Glenn-IT/WBACFSPWI-Web-Based-Automatic-Controller-for-Solar-Powered-Water-Irrigation/Progress.md

# Project Progress

progress: 90
status: Ongoing
note: Completed standalone Arduino hardware sketches, HW-080 surface moisture integration, star wiring breadboard diagrams, and automated controller firmware.

Backend: 85
Frontend: 85
Database: 85
Arduino Hardware & Integration: 90
Total: 90
