Glenn-IT/WBACFSPWI-Web-Based-Automatic-Controller-for-Solar-Powered-Water-Irrigation/arduino/figure4_prototype_guide.html

Hardware Prototype Guide

# Figure 4 Standalone ESP32 Prototype Wiring

Complete electrical schematic, pinout mapping, and star-ground wiring instructions for the solar-powered automatic irrigation prototype shown in Figure 4.

### Live Digital Prototype Available

You can test this exact hardware circuit interactively in your browser with animated water pumps, solar irradiance controls, and smartphone telemetry.

Open Interactive Simulator → Open Mobile Phone View ← Master Hardware Hub

🔌 Visual Star Wiring Diagram (Figure 4 Architecture)

This vector diagram illustrates the physical jumper connections between the Solar Panel, Solar Charge Controller, 12V Battery, Solderless Breadboard, ESP32, Soil Probe, Relay Module, and 12V Water Pump.

📋 Full Hardware Connection Matrix

Tag | Source Component | Source Pin / Terminal | Destination Component | Destination Pin | Wire Color | Purpose & Interface
SOL-01 | Solar Panel (30W) | PV Positive (+) | Solar Charge Controller | PV (+) Terminal | Red | Solar harvesting input (18V–21V Voc)
SOL-02 | Solar Panel (30W) | PV Negative (-) | Solar Charge Controller | PV (-) Terminal | Black | Solar panel ground return
BAT-01 | 12V Battery | Positive (+) Terminal | Solar Charge Controller | BATT (+) Terminal | Red | Battery charging and storage connection
BAT-02 | 12V Battery | Negative (-) Terminal | Solar Charge Controller | BATT (-) Terminal | Black | Battery ground reference
PWR-01 | Solar Controller / Battery | Load / Batt (+) | Breadboard | Red Power Rail (+5V / +12V) | Red | System power distribution bus
GND-01 | Solar Controller / Battery | Load / Batt (-) | Breadboard | Blue Ground Rail (GND) | Black | Star common ground bus
SIG-01 | ESP32 DevKit | GPIO 34 (ADC1) | Soil Moisture Module | AO (Analog Out) | Green | Analog soil moisture voltage sensing (12-bit)
SIG-02 | ESP32 DevKit | GPIO 25 | Soil Moisture Module | VCC | Yellow | Power gating pin (prevents probe corrosion)
ACT-01 | ESP32 DevKit | GPIO 26 | Relay Module | IN (Control Pin) | Blue | Active-LOW digital relay trigger
ACT-02 | Relay Module | Normally Open (NO) | 12V DC Water Pump | Positive (+) Lead | Red | Switched high-side 12V pump power
ACT-03 | 12V DC Water Pump | Negative (-) Lead | Breadboard | Blue Ground Rail (GND) | Black | Pump motor return path to common ground

📦 Prototype Bill of Materials (BOM)

- 1x 12V/30W Polycrystalline Solar Panel with standard mounting bracket
- 1x 10A/20A 12V PWM Solar Charge Controller with integrated LCD status screen
- 1x 12V Motorcycle Lead-Acid or 3S 18650 Li-ion Battery Pack (11.1V–12.6V)
- 1x 830-Point Solderless Breadboard with dual power distribution buses
- 1x ESP32 NodeMCU-32S / ESP-WROOM-32 30-pin/38-pin Development Board
- 1x Soil Moisture Sensor Module with LM393 comparator & dual-prong probe
- 1x 5V/3.3V 1-Channel Optocoupler Relay Module (10A 250VAC / 30VDC rating)
- 1x 12V DC Submersible/Diaphragm Miniature Water Pump with silicone tubing
- Assorted Jumper Wires (Male-to-Male and Male-to-Female)
