Glenn-IT/WBACFSPWI-Web-Based-Automatic-Controller-for-Solar-Powered-Water-Irrigation/arduino/wbacfspwi_arduino_controller/wiring_guide.html

Master Full Controller Wiring Schematic

# WBACFSPWI Master Star Breadboard Assembly Guide

Complete High-Visibility Wiring Schematic: 30W Solar Panel + Solar Charge Controller/BMS + 12V Motorcycle / 3S Battery + Buck (5V) Main Power | Dark Breadboard | Connected Star Jumpers | HW-080 & Capacitive Dual-Sensor Setup

🏠 Master Hub Test 01: Root Soil Test 02: HW-080 Surface Test 03: Relay & Pump Test 04: Battery Monitor Test 05: Solar Monitor Test 06: Solar Charger Test 07: Dual Sensor Test 08: 12V Presentation 📡 Test 09: ESP8266 WiFi 📱 Test 10: GSM SMS Alert 🚀 Full Controller ⚡ Interactive Prototype

🎛️

Interactive Subsystem & Module Filter

Check options below to show/hide specific circuits on the schematic diagram and connection matrix table.

🌱 Root Soil + HW-080 Only 🔬 All Sensors Only ⚡ Power & Actuators ✨ Show All (Reset)

🌱 Root Soil Moisture (Capacitive V1.2) 🌊 HW-080 Surface Moisture Probe ☀️ 30W Solar Panel & 22V Divider 🔌 3S Solar Charge Controller / BMS 🔋 3S Battery Pack & 12V Divider ⚡ LM2596 Buck & 5V Power Rails 🚰 5V Relay & Submersible Water Pump 📡 NodeMCU ESP8266MOD WiFi Bridge 📱 SIM800L GSM SMS Alert System

Showing 9 of 9 Subsystem Modules

⚡

Master Circuit Schematic (Dark Breadboard with 100% Fully Connected Terminals & Solar Charger)

Star 5V Logic Power (Red)

Star Common Ground 0V (Blue)

Solar Charger to Battery (12.6V CC/CV)

12V Battery Power / A2 Divider (Purple)

22V Solar Power / A3 Divider (Gold)

Relay Trigger D7 / DO D2 (Amber)

Capacitive Power Gate D8 (Pink)

Root Soil Signal A0 (Green)

HW-080 Surface Signal A1 (Cyan)

NodeMCU ESP8266 WiFi Bridge (D9 RX / D10 TX)

📊

Complete Master Breadboard Pin & Component Connection Matrix

Wire ID | Origin Node (From) | Breadboard Tie-Point | Destination Node (To) | Wire Color | Signal Type / Voltage | Operational Function & Safety Rule
CHG-01 | 30W Solar (+) Lead [0-22V] | Direct Wire | Solar Charger SOLAR IN+ | Gold / Red | 0V – 21.6V DC | Raw solar output into 3S MPPT/PWM solar charge controller module.
CHG-02 | 30W Solar (-) Lead | Top Blue Rail (-) | Solar Charger SOLAR IN- | Blue / Black | 0.00V (Common) | Solar ground return tied into common Star Ground bus.
CHG-03 | Solar Charger BAT+ Out | Direct Heavy Wire | 12V Motorcycle / 3S Battery (+) [11.1V–14.4V] | Purple / Red | 12.60V–14.40V Charge | Regulated charging current feeds 12V Motorcycle / 3S battery pack (overcharge protected).
CHG-04 | Solar Charger BAT- Out | Top Blue Rail (-) | 12V Motorcycle / 3S Battery (-) Terminal | Blue / Black | 0.00V (Common) | Battery charge ground return to central Star Ground reference.
PWR-01 | 12V Motorcycle / 3S Battery (+) [11.1V–14.4V] | Direct Wire | LM2596 Buck IN+ | Red | 11.1V – 14.4V DC | Raw high-capacity battery supply to Buck step-down converter (10A inline fuse recommended).
PWR-02 | LM2596 Buck OUT+ | Top Red Rail (+) | Arduino 5V Pin | Red | 5.00V DC Regulated | Primary Logic Power: Powers Arduino ATmega328P MCU.
PWR-03 | Top Red Rail (+) | Direct Jumper | 5V Relay Module VCC | Red | 5.00V DC | Powers optocoupler coil driver circuitry.
PWR-04 | Top Red Rail (+) | Direct Jumper | HW-080 Driver VCC | Red | 5.00V DC | Powers LM393 surface moisture comparator driver board.
PWR-05 | Top Red Rail (+) | Direct Jumper | NodeMCU Vin Pin | Red | 5.00V DC Regulated | Supplies regulated 5V into NodeMCU onboard AMS1117 3.3V LDO regulator.
GND-01 | LM2596 Buck OUT- | Top Blue Rail (-) | Arduino GND Pin | Blue / Slate | 0.00V (Star GND) | Star Ground Reference: Central zero-volt reference point.
GND-02 | 12V Motorcycle / 3S Battery (-) Terminal | Top Blue Rail (-) | Buck IN- Terminal | Blue / Black | 0.00V (Common) | Ties battery negative return directly into central star ground.
GND-03 | 30W Solar (-) Terminal | Top Blue Rail (-) | Star Common GND | Blue / Black | 0.00V (Common) | Ties solar panel return into common ground bus.
GND-04 | Relay GND & Sensors GND | Top Blue Rail (-) | Star Common GND | Blue / Slate | 0.00V | Ground returns for relay coil, capacitive sensor, and HW-080.
GND-05 | NodeMCU GND & 2kΩ Div | Top Blue Rail (-) | Star Common GND | Blue / Slate | 0.00V (Common) | Common 0V reference return for ESP8266 logic and RX voltage divider.
ACT-01 | 12V Motorcycle / 3S Battery (+) [11.1V–14.4V] | Direct Heavy Wire | Relay COM Terminal | Purple / Red | 11.1V–14.4V High Current | Feeds raw un-stepped battery power to relay switch contacts (16/18 AWG recommended).
ACT-02 | Relay NO Terminal | Row 35 (Diode Cathode) | DC Pump (+) Lead | Blue | Switched 12V DC | Powers water pump motor when relay is engaged.
ACT-03 | DC Pump (-) Lead | Row 40 (Diode Anode) | Star GND Rail (-) | Blue / Black | Motor Return GND | Motor return current flows into Star GND, bypassing Arduino MCU.
ACT-04 | Row 35 (Cathode) | 1N4007 Diode Body | Row 40 (Anode) | Diode Component | Flyback Clamp | Inductive Spike Suppression: Clamps reverse-EMF kickback.
SIG-01 | Arduino Pin D7 | Direct Jumper | Relay IN Pin | Amber | 5V Digital Out | Active LOW trigger with 3-minute continuous runtime safety cap.
SIG-02 | Arduino Pin D8 | Direct Jumper | Capacitive Sensor VCC | Pink / Red | 5V Digital Gate | Powers capacitive sensor only during sampling (anti-corrosion).
SIG-03 | Capacitive Sensor AOUT | Direct Jumper | Arduino Pin A0 | Green | 0V – 3.0V Analog | Root zone soil moisture reading (Air ~417, Water ~153).
SIG-04 | HW-080 Sensor AO | Direct Jumper | Arduino Pin A1 | Cyan | 0V – 5.0V Analog | Surface ponding depth controller (Dry=1020, Mid=663, Full=568). Maintains 50.0% target layer (Target 50.0%, Refill min 45.0%).
SIG-05 | Row 10 (R1/R2 Junction) | 100kΩ / 33kΩ Divider | Arduino Pin A2 | Purple | 0V – 3.57V Analog | Battery voltage monitor (Vbatt / 4.0303). Safe up to 14.4V (3.57V ADC). Cutoff < 10.0V.
SIG-06 | Row 25 (R3/R4 Junction) | 100kΩ / 20kΩ Divider | Arduino Pin A3 | Gold / Yellow | 0V – 3.67V Analog | Solar panel monitor (Vsolar / 6.000). Harvesting > 12.0V.
COMM-01 | NodeMCU Pin D2 (TX) | Direct Jumper Wire | Arduino Pin D9 (RX) | Cyan | 3.3V Digital (Safe) | NodeMCU 3.3V TX logic connects directly to Arduino 5V TTL RX (exceeds 3.0V HIGH threshold). Streams web commands to Uno.
COMM-02 | Arduino Pin D10 (TX) | 1kΩ / 2kΩ Divider | NodeMCU Pin D1 (RX) | Amber / Gold | 3.33V Stepped Down | Level Shifted: 5V TX stepped down to 3.3V via 1kΩ/2kΩ divider to protect ESP8266 3.3V input. Streams telemetry JSON to WiFi.
COMM-03 | Arduino / NodeMCU | Dual Wireless / USB | Web Dashboard & API | WiFi 802.11 b/g/n | 115200 / 9600 Baud | Wireless serial-to-WiFi bridge replaces physical USB tether; full bidirectional telemetry + remote override commands.
COMM-04 | GSM Module TXD / 5VT | Direct Jumper Wire | Arduino Pin D2 (RX) | Green | 0V – 5.0V TTL Logic (Safe) | SIM900A 5VT / SIM800L TXD logic connects directly to Arduino digital input (safely read by ATmega328P). Receives AT responses & SMS delivery confirmation.
COMM-05 | Arduino Pin D3 (TX) | Direct Jumper (SIM900A 5VR) / 1kΩ/2kΩ Divider (SIM800L) | GSM Module 5VR / RXD | Amber / Orange | 5.0V TTL / 3.3V Shifted | AT Transmit Link: For SIM900A, connect Arduino D3 directly to the 5VR pin (board has onboard level shifter). For raw SIM800L, step down 5V to 3.3V via 1kΩ/2kΩ divider. Sends AT+CMGS SMS commands.

#### ⚡ Golden Rules for Error-Free Assembly

- 1. Solar Charging & BMS Integration: Connect 30W Solar Panel outputs to the SOLAR IN+ and SOLAR IN- terminals of the Solar Charge Controller. The BAT+ and BAT- outputs feed the 12V Motorcycle / 3S battery pack to provide regulated charging up to 14.4V bulk (Lead-Acid) or 12.6V (3S Li-ion).
- 2. Calibrate Buck Converter First: Disconnect Arduino and modules. Turn on 12V Battery power and adjust Buck potentiometer screw until multimeter reads 5.00V ± 0.05V before connecting to breadboard.
- 3. Check 1N4007 Diode Stripe: The silver/white band (Cathode) MUST plug into Row 35 (switched 12V from relay). Connecting in reverse will short-circuit the relay!
- 4. Star Ground Rule: Ensure all module grounds (Buck OUT-, Battery -, Solar Charger -, Solar Panel -, Arduino GND, Sensor GND, Relay GND) terminate on the blue breadboard rail to eliminate inductive voltage bounce.
- 5. Dual Telemetry & Wireless WiFi Bridge: NodeMCU ESP8266MOD can replace the physical USB tether. Connect NodeMCU Vin to Star 5V Rail and GND to Star GND Rail. Connect NodeMCU Pin D2 (TX) directly to Arduino Pin D9 (RX). Connect Arduino Pin D10 (TX) through the 1kΩ / 2kΩ level shifter divider to NodeMCU Pin D1 (RX). Arduino telemetry is streamed to both USB Serial (115200) and SoftwareSerial espSerial (9600) for seamless WiFi dashboard streaming and remote control.
- 6. Cellular Alert Module (SIM900A / SIM800L): Draws up to 2.0A peak burst current during RF transmission. Power via LM2596 (5.0V for SIM900A 5V pin, or 4.0V for raw VBAT) with a 1000μF capacitor across power and ground (NOT Arduino 5V pin). Arduino Pin D2 (RX) reads GSM 5VT/TXD directly; Arduino Pin D3 (TX) connects directly to SIM900A 5VR (or through a 1kΩ/2kΩ divider if using raw 3.3V SIM800L).
