Glenn-IT/WBACFSPWI-Web-Based-Automatic-Controller-for-Solar-Powered-Water-Irrigation/arduino/10_gsm_sms_irrigation_alert_test/wiring_guide.html

Hardware Test Suite 10

# GSM Module (SIM800L / SIM900) SMS Alert Wiring Guide

Automated SMS Dispatches: Irrigation Started (<45%), Stopped (≥50%), and Restarted Cycles

🏠 Master Hub Test 01: Root Soil Test 02: HW-080 Surface Test 03: Relay & Pump Test 04: Battery Monitor Test 05: Solar Monitor Test 06: Solar Charger Test 07: Dual Sensor Test 08: 12V Presentation 📡 Test 09: ESP8266 WiFi 📱 Test 10: GSM SMS Alert 🚀 Full Controller

⚠️ Critical Cellular Module Power Directives (SIM800L & SIM900A / S2-1040U-Z1K0B)

Both the SIM800L and SIM900A (S2-1040U-Z1K0B) draw up to 2.0 Amperes peak burst current during cellular RF transmission. DO NOT attempt to power them from the Arduino 5V or 3.3V pin. If using a SIM900A mini development board with a 5V/VCC5 pin, tune your LM2596 to 5.00V DC. If using raw VCC/VBAT (3.7V–4.4V), tune the LM2596 to 4.00V DC. Always place a 1000μF capacitor across the power pins and tie all grounds together!

📱

Interactive Star Breadboard Diagram (SIM800L / SIM900A SMS Alert System)

Star 4.0V-5.0V Logic & GSM Power (Red)

Star Common Ground 0V (Blue)

Arduino D3 5V TX Output (Amber)

Level-Shifted 3.33V Tap → GSM RXD (Emerald)

GSM TXD 2.8V → Arduino D2 RX & Water AO (Cyan)

Arduino D7 → Relay IN Active LOW (Yellow)

📋

Complete Interconnect Matrix & Pin Mapping

Signal ID | Origin Node | Breadboard Route / Component | Destination Node | Voltage / Logic Level | Function & Safety Directive
PWR-GSM | LM2596 Buck OUT+ | Star Red Rail (+) with 1000μF Cap | SIM800L VCC / SIM900A 5V | 4.00V–5.00V DC (2.0A Peak) | Dedicated high-current supply (4.0V for raw SIM800L, 5.0V for SIM900A mini board).
GND-ALL | Star Blue Rail (-) | Common Ground Bus | Arduino / GSM GND | 0.00V Reference | CRITICAL: All module grounds must be tied together.
COMM-01 | GSM TXD / SIM900A 5VT | Direct Jumper Wire | Arduino Pin D2 (RX) | 2.8V–5.0V TTL Logic | Arduino detects 2.8V–5V as HIGH reliably; direct connection is safe.
COMM-02 | Arduino Pin D3 (TX) | 1kΩ / 2kΩ Divider (or Direct 5VR) | GSM RXD / SIM900A 5VR | 5.0V → 3.3V Shift (or 5V TTL) | Protects raw 3.3V UART receiver. Connect directly to SIM900A 5VR if board has onboard level shifter.
SIG-TRIG | Arduino Pin A1 | Direct Jumper Wire | JSN-SR04T TRIG | 5V Digital OUT | Sends 10µs ultrasonic trigger pulse for surface water level measurement. (Legacy: HW-080 AO).
SIG-ECHO | JSN-SR04T ECHO | Direct Jumper Wire | Arduino Pin A4 | 5V TTL Digital IN | Acoustic pulse-echo duration proportional to water distance (45% Refill / 50% Target).
ACT-PUMP | Arduino Pin D7 | Direct Jumper Wire | 5V Relay Module IN | 5V Digital (Active LOW) | Switches 12V DC Water Pump with 5s anti-splash & 180s continuous run cap.

🚀

Step-by-Step Hardware Verification Sequence

1. Insert Micro-SIM Card: Insert an activated SIM card with regular SMS load or promo. Ensure SIM PIN is disabled.
2. Power Up & Observe NET LED: Apply power to the LM2596 buck converter and Arduino. The SIM800L NET LED will blink rapidly (1/sec) while searching for cellular signal, and slow down to 1 blink every 3 seconds once registered to the cell tower.
3. Open Arduino IDE Serial Monitor: Set baud rate to 115200 baud. Type s to send an instant verification SMS to your phone.
4. Live Water Level Simulation: Type 1 to simulate Trigger 1 (Irrigation Started <45%). Type 2 to simulate Trigger 2 (Irrigation Stopped ≥50%). Type 3 to simulate Trigger 3 (Irrigation Restarted <45% again).
