Glenn-IT/WBACFSPWI-Web-Based-Automatic-Controller-for-Solar-Powered-Water-Irrigation/arduino/11_jsn_sr04t_ultrasonic_water_level_test/setup_presentation.html

🔘 Tailored Container Geometry

# 18 cm × 18 cm Circular Container Visual Setup

Exact physical mounting, acoustic cone geometry, and calibration formulas for your 18 cm diameter × 18 cm height circular container.

🏠 Master Hub 🔌 Breadboard Wiring Guide 📐 18×18cm Container Setup Test 02: HW-080 Legacy Test 07: Dual Sensor 🚀 Full Controller

🔘

Interactive 18×18 cm Circular Container & Acoustic Simulator

Container: Ø 18.0 cm × 18.0 cm | Usable Depth: 12.0 cm | Clearance: 21.0 cm | Floor Dist: 33.0 cm

🌾 18cm Rice Model (12cm water) 💧 18cm Pure Reservoir (15cm water) 🌱 Shallow Tray (5cm water)

18cm Container Water Depth 6.0 cm

0.0 cm (Dry) 5.4 cm (45%) 6.0 cm (50% Target) 12.0 cm (100% Full) >14cm (Blind)

Empty (0%) Refill (<45%) Buffer (48%) Target (50%) Max (100%) Blind Zone ⚠️

Measured Distance

27.0 cm

Ponding Level

50.0%

Sensor Clearance

21.0 cm

Usable Bed Depth

12.0 cm

🛑

TARGET REACHED (50.0%)

12V Water Pump turns OFF. Anti-splash run & 10s wave settling complete.

📐

Three Golden Rules for Mounting in an 18 cm Circular Container

RULE 1: STRICT CENTERING

### Center the Probe at Exactly 9.0 cm

Because your container is an 18 cm diameter circle, the radius is exactly 9.0 cm. The JSN-SR04T must be positioned directly in the geometric center.

Why: The sensor has a $\sim 50^\circ$ acoustic sound cone. If you mount it even 2 cm off-center, the sound waves will bounce off the curved sidewall before reaching the water surface!

RULE 2: HEIGHT CALCULATION

### Transducer Height Above the Rim

The JSN-SR04T has a 20 cm blind zone.

• If you leave a 3 cm air gap inside the pot (so water doesn't spill over the top rim at 100% full):
• The transducer face should sit 18.0 cm above the top rim of the container ($18\text{cm} + 3\text{cm} = 21.0\text{cm}$ total clearance down to water).

RULE 3: SIMPLE CROSS-BRIDGE

### Make a Simple Wood or Acrylic Bridge

Cut a 20 cm strip of wood, plastic ruler, or acrylic. Place it across the circular opening of the container with two small vertical risers (18 cm tall).

Drill a 20 mm hole in the center of the bridge and insert the JSN-SR04T probe pointing directly straight down into the center of the pot.

💻

Calibration Constants for Your Arduino Sketch (18×18 cm)

Here are the pre-calculated geometry values for your 18×18 cm container. You can also calibrate them live in the Serial Monitor by typing c (full mark) and e (empty floor):

// Constants for 18 cm x 18 cm Circular Container:
const float SENSOR_CLEARANCE_CM = 21.0; // Air gap down to 100% full water mark (min 20cm blind zone)
const float CONTAINER_DEPTH_CM = 12.0; // Usable water depth (0% to 100% flood)
// Floor Distance = 21.0 + 12.0 = 33.0 cm

// Autonomous Irrigation Decision Thresholds:
// 50.0% Target = 6.0 cm water depth -> Measured Distance = 27.0 cm (Pump OFF)
// 45.0% Refill = 5.4 cm water depth -> Measured Distance = 27.6 cm (Pump ON)
