Glenn-IT/WBACFSPWI-Web-Based-Automatic-Controller-for-Solar-Powered-Water-Irrigation/arduino/11_jsn_sr04t_ultrasonic_water_level_test/wiring_guide.html

Star Wiring Test 11

# JSN-SR04T Waterproof Ultrasonic Level Sensor

Main Power: Star 5.0V Rail | Non-Contact Overhead Acoustic Depth Sensing | Replaces HW-080

🏠 Master Hub Test 01: Root Soil Test 02: HW-080 Surface Test 03: Relay & Pump Test 04: Battery Monitor Test 05: Solar Monitor Test 06: Solar Charger Test 07: Dual Sensor Test 08: 12V Presentation 📡 Test 09: ESP8266 WiFi 📱 Test 10: GSM SMS Alert 🔊 Test 11: JSN-SR04T Ultrasonic 📐 Physical Setup Presentation 🚀 Full Controller

🔊

Interactive Star Breadboard Diagram (JSN-SR04T Transceiver & Waterproof Overhead Transducer)

📋

JSN-SR04T Star Wiring Connection Matrix

Wire ID | Origin Node (From) | Destination Node (To) | Wire Color | Voltage / Logic | Purpose & Operational Rule
PWR-01 | LM2596 Buck OUT+ | Breadboard Top Red Rail (+) | Red | 5.00V DC Regulated | Primary Star 5V logic bus. Step-down from 12V Battery.
GND-01 | LM2596 Buck OUT- | Breadboard Top Blue Rail (-) | Blue / Black | 0.00V (Star GND) | Central Star Ground reference.
PWR-02 | Star 5V Rail (+) | Arduino Uno 5V Header Pin | Red | 5.00V DC | Powers Arduino ATmega328P MCU from clean Star 5V rail.
GND-02 | Star GND Rail (-) | Arduino Uno GND Header Pin | Blue / Slate | 0.00V | Arduino logic ground return into central Star GND.
PWR-03 | Star 5V Rail (+) | JSN-SR04T Pin 5V (VCC) | Red | 5.00V DC (~30mA) | Powers ultrasonic transceiver board and 40kHz burst generator.
GND-03 | Star GND Rail (-) | JSN-SR04T Pin GND | Blue / Slate | 0.00V | Ultrasonic module ground return into central Star GND.
SIG-01 | Arduino Pin A1 (Output) | JSN-SR04T Pin TRIG | Cyan / Orange | 5.0V TTL Pulse | Sends 10 microsecond trigger pulse to fire acoustic burst.
SIG-02 | JSN-SR04T Pin ECHO | Arduino Pin A4 (Input) | Green | 5.0V TTL Pulse | High pulse duration indicates round-trip acoustic echo time.

#### ⚠️ Critical Installation Rule: The 25 cm Blind Zone Air Clearance

The JSN-SR04T transducer has a physical blind zone of 20 cm to 25 cm due to internal transducer ringing damping. To ensure accurate operation:

- The transducer must be rigidly fastened at least 25 cm to 30 cm above the container's 100% full flood level.
- This 25 cm zone must always remain air; water must never rise closer than 20 cm to the transducer face.
- Ensure the downward acoustic cone ($45^\circ$ beam angle) is unobstructed by side walls, hoses, or pump cords.

⚙️

Interactive Serial Monitor Calibration (115200 Baud)

### 1. Calibration Steps

1. Flash 11_jsn_sr04t_ultrasonic_water_level_test.ino to your Arduino Uno.
2. Open the Serial Monitor at 115200 baud.
3. Step 1 (100% Full Mark): Fill container to target 100% flood mark. Press c. The sketch records this distance as sensorClearanceCM.
4. Step 2 (0% Empty Mark): Drain container completely to floor. Press e. The sketch calculates containerDepthCM = measured - clearance.
5. Step 3 (Diagnostic Burst): Press t to verify jitter is $\le 1.0\text{ cm}$.

### 2. Serial Commands Reference

Key | Action
c / C | Calibrate 100% Full Flood Mark
e / E | Calibrate 0% Container Floor Mark
t / T | Run 10-ping acoustic stability burst test
+ / - | Fine-tune clearance offset by ±0.5 cm
h / ? | Display command help and current constants
