Glenn-IT/WBACFSPWI-Web-Based-Automatic-Controller-for-Solar-Powered-Water-Irrigation/arduino/02_surface_water_level_test/wiring_guide.html

Star Wiring Test 02

# HW-080 Moisture Sensor (Surface & Ponding Depth)

Main Power: 3S Battery + Buck (5.0V) | Star Wiring | HW-080 Probe + LM393 Comparator Module

🏠 Master Hub Test 01: Root Soil Test 02: HW-080 Surface Test 03: Relay & Pump Test 04: Battery Monitor Test 05: Solar Monitor Test 06: Solar Charger Test 07: Dual Sensor Test 08: 12V Presentation 📡 Test 09: ESP8266 WiFi 📱 Test 10: GSM SMS Alert 🚀 Full Controller

🌊

Interactive Star Breadboard Diagram (HW-080 Moisture Probe & LM393 Driver Board)

📊

HW-080 Moisture Sensor Star Wiring Reference Table

From (Source) | Breadboard Star Node | Target HW-080 Pin | Wire Color | Signal Description & Threshold
Buck OUT+ (5.0V) | Star 5V Red Rail (+) | HW-080 VCC Pin | Red | Main Power: Regulated 5.00V supply to LM393 driver board.
Buck OUT- (GND) | Star GND Blue Rail (-) | HW-080 GND Pin | Black / Slate | Star Ground: Return path connected directly to central Star GND.
Arduino Pin A1 | Row 15 (Terminal A) | HW-080 AO Pin | Cyan | Analog Output: High ADC (~950) when dry; Low ADC (~300) when flooded.
Arduino Pin D2 | Direct Wire (Optional) | HW-080 DO Pin | Amber (Dashed) | Digital Threshold: Triggers LOW when water crosses potentiometer setpoint.
Driver Header (P1/P2) | 2-Wire Jumper | HW-080 Probe Board | Green Pair | Conductive track loop sensing resistance across standing surface water.

#### 💧 HW-080 Inverted Resistance Behavior

Analog Reading (AO):
- Dry Surface (Air): High resistance → ADC reads ~850–1023 (0% flood).
- Standing Water (Ponding): Low resistance → ADC drops to ~250–450 (75%–100% flood).
When ponding depth reaches ≥ 75%, the controller automatically halts the pump to prevent miniature rice field flooding.
