Glenn-IT/WBACFSPWI-Web-Based-Automatic-Controller-for-Solar-Powered-Water-Irrigation/arduino/03_relay_pump_test/wiring_guide.html

Star Wiring Test 03

# 5V Relay Module & DC Water Pump

Main Power: 3S Battery + Buck (5.0V) | Star Wiring | On-Breadboard 1N4007 Flyback Diode Protection

🏠 Master Hub Test 01: Root Soil Test 02: HW-080 Surface Test 03: Relay & Pump Test 04: Battery Monitor Test 05: Solar Monitor Test 06: Solar Charger Test 07: Dual Sensor Test 08: 12V Presentation 📡 Test 09: ESP8266 WiFi 📱 Test 10: GSM SMS Alert 🚀 Full Controller

⚡

Interactive Star Breadboard Diagram (Relay & Pump with Isolated Motor Circuit & Flyback Diode)

📊

Star Wiring & Power Architecture Reference Table

From (Source) | Breadboard Star Node | Target Component | Wire Color | Power / Signal Role
Buck OUT+ (5.0V) | Star 5V Red Rail (+) | Arduino 5V & Relay VCC | Red | Main Power: Regulated 5.00V logic supply.
Buck OUT- (GND) | Star GND Blue Rail (-) | Arduino GND, Relay GND, Battery (-) | Black / Slate | Star Ground Node: Central zero-volt reference eliminating ground bounce.
Relay NO terminal | Row 20 (Diode Cathode) | Pump (+) Lead | Blue | Switched 12V power to pump motor with flyback cathode.
Star GND Rail | Row 25 (Diode Anode) | Pump (-) Lead | Black / Slate | Return ground path for pump motor with flyback anode.

#### ⚡ Star Wiring & Flyback Protection Architecture

Main Power: 3S Battery + Buck Converter (5.00V) powers the entire system.
Star Ground: Motor current flows strictly through Row 20 & 25 back to the Star GND point, completely bypassing the Arduino MCU to avoid resets or analog noise.
USB Connection: Used only as a Serial Data Bridge for web telemetry.
