Glenn-IT/WBACFSPWI-Web-Based-Automatic-Controller-for-Solar-Powered-Water-Irrigation/arduino/04_battery_voltage_test/wiring_guide.html

Star Wiring Test 04

# 3S 18650 Battery Voltage Monitor

Main Power: 3S Battery + Buck (5.0V) | Star Wiring | 100kΩ / 33kΩ Voltage Divider

🏠 Master Hub Test 01: Root Soil Test 02: HW-080 Surface Test 03: Relay & Pump Test 04: Battery Monitor Test 05: Solar Monitor Test 06: Solar Charger Test 07: Dual Sensor Test 08: 12V Presentation 📡 Test 09: ESP8266 WiFi 📱 Test 10: GSM SMS Alert 🚀 Full Controller

🔋

Interactive Star Breadboard Diagram (Battery Voltage Divider Network)

📊

Star Wiring & Power Architecture Reference Table

From (Source) | Breadboard Star Node | Target Component | Wire Color | Power / Signal Role
Buck OUT+ (5.0V) | Star 5V Red Rail (+) | Arduino 5V Pin | Red | Main Power: Regulated 5.00V logic supply.
Buck OUT- (GND) | Star GND Blue Rail (-) | Arduino GND & Battery (-) | Black / Slate | Star Ground Node: Central zero-volt reference point.
Battery (+) [12.6V] | Row 5 (R1 Top) | Resistor R1 (100kΩ) | Red | Raw battery voltage to divider input.
Row 15 (Junction Tap) | R1 bottom & R2 top | Arduino Pin A2 | Purple | $V_{\text{pin}} = \frac{V_{\text{batt}}}{4.0303}$. Scaled to max ~3.125V for ADC safety.

#### ⚡ Star Wiring & USB Data Bridge Architecture

Primary Power: 3S Battery + Buck Converter (5.00V) powers the entire system.
USB Connection: The USB cable is strictly a Serial Data Bridge (115200 baud) for transferring live sensor telemetry to the web dashboard.
