Glenn-IT/WBACFSPWI-Web-Based-Automatic-Controller-for-Solar-Powered-Water-Irrigation/arduino/05_solar_voltage_test/wiring_guide.html

Star Wiring Test 05

# 30W Solar Panel Voltage Monitor

Main Power: 3S Battery + Buck (5.0V) | Star Wiring | 100kΩ / 20kΩ Voltage Divider

🏠 Master Hub Test 01: Root Soil Test 02: HW-080 Surface Test 03: Relay & Pump Test 04: Battery Monitor Test 05: Solar Monitor Test 06: Solar Charger Test 07: Dual Sensor Test 08: 12V Presentation 📡 Test 09: ESP8266 WiFi 📱 Test 10: GSM SMS Alert 🚀 Full Controller

☀️

Interactive Star Breadboard Diagram (Solar Resistor Divider Circuit)

📊

Star Wiring & Power Architecture Reference Table

From (Source) | Breadboard Star Node | Target Component | Wire Color | Power / Signal Role
Buck OUT+ (5.0V) | Star 5V Red Rail (+) | Arduino 5V Pin | Red | Main Power: Regulated 5.00V logic supply.
Buck OUT- (GND) | Star GND Blue Rail (-) | Arduino GND & Solar (-) | Black / Slate | Star Ground Node: Central zero-volt reference point.
Solar Panel (+) [22.0V] | Row 5 (R3 Top) | Resistor R3 (100kΩ) | Red | Raw solar open-circuit voltage to divider input.
Row 15 (Junction Tap) | R3 bottom & R4 top | Arduino Pin A3 | Yellow | $V_{\text{pin}} = \frac{V_{\text{solar}}}{6.000}$. Scaled to max ~3.667V for ADC safety.

#### ⚡ Star Wiring & USB Data Bridge Architecture

Primary Power: 3S Battery + Buck Converter (5.00V) powers the entire system.
USB Connection: The USB cable is strictly a Serial Data Bridge (115200 baud) for transferring live sensor telemetry to the web dashboard.
