Glenn-IT/WBACFSPWI-Web-Based-Automatic-Controller-for-Solar-Powered-Water-Irrigation/arduino/06_solar_charger_battery_test/wiring_guide.html

Test 06: Solar Charger & Battery Monitor

# WBACFSPWI Solar Charger & Battery Charging Test Guide

Standalone Breadboard Test Circuit: 30W Solar Panel + 3S Solar Charger/BMS Module + 3S Battery Pack + Buck (5V) Main Logic Power

🏠 Master Hub Test 01: Root Soil Test 02: HW-080 Surface Test 03: Relay & Pump Test 04: Battery Monitor Test 05: Solar Monitor ⚡ Test 06: Solar Charger Test 07: Dual Sensor 🔬 Test 08: Presentation 📡 Test 09: ESP8266 WiFi 📱 Test 10: GSM SMS Alert 🚀 Full Controller

🎛️

Interactive Test 06 Circuit Filter

Toggle specific components to isolate the solar charger, battery pack, dividers, and buck converter.

☀️ Solar Charger + Battery 📊 Voltage Dividers (A2/A3) ✨ Show All (Reset)

☀️ 30W Solar Panel & 22V Divider 🔌 3S Solar Charge Controller / BMS 🔋 3S Battery Pack & 12V Divider ⚡ LM2596 Buck & 5V Power Rails

Showing 4 of 4 Test Modules

⚡

Test 06 Schematic (30W Solar Panel + 3S Charger + 3S Battery + Dividers A2/A3)

Star 5V Logic Power (Red)

Star Common Ground 0V (Blue)

Solar Charger to Battery (12.6V CC/CV)

12V Battery Power / A2 Divider (Purple)

22V Solar Power / A3 Divider (Gold)

📊

Test 06 Pin & Component Connection Matrix

Wire ID | Origin Node (From) | Breadboard Tie-Point | Destination Node (To) | Wire Color | Signal Type / Voltage | Operational Function & Safety Rule
CHG-01 | 30W Solar (+) Lead [0-22V] | Direct Wire | Solar Charger SOLAR IN+ | Gold / Red | 0V – 21.6V DC | Raw solar output into 3S MPPT/PWM solar charge controller module.
CHG-02 | 30W Solar (-) Lead | Top Blue Rail (-) | Solar Charger SOLAR IN- | Blue / Black | 0.00V (Common) | Solar ground return tied into common Star Ground bus.
CHG-03 | Solar Charger BAT+ Out | Direct Heavy Wire | 3S Battery (+) [12.6V] | Purple / Red | 12.60V CC/CV Charge | Regulated charging current feeds 3S 18650 battery pack (overcharge protected).
CHG-04 | Solar Charger BAT- Out | Top Blue Rail (-) | 3S Battery (-) Terminal | Blue / Black | 0.00V (Common) | Battery charge ground return to central Star Ground reference.
PWR-01 | 3S Battery (+) [12.6V] | Direct Wire | LM2596 Buck IN+ | Red | 11.1V – 12.6V DC | Raw high-capacity battery supply to Buck step-down converter.
PWR-02 | LM2596 Buck OUT+ | Top Red Rail (+) | Arduino 5V Pin | Red | 5.00V DC Regulated | Primary Logic Power: Powers Arduino ATmega328P MCU.
GND-01 | LM2596 Buck OUT- | Top Blue Rail (-) | Arduino GND Pin | Blue / Slate | 0.00V (Star GND) | Star Ground Reference: Central zero-volt reference point.
SIG-05 | Row 10 (R1/R2 Junction) | 100kΩ / 33kΩ Divider | Arduino Pin A2 | Purple | 0V – 3.13V Analog | Battery voltage monitor (Vbatt / 4.0303). Lockout < 10.0V.
SIG-06 | Row 25 (R3/R4 Junction) | 100kΩ / 20kΩ Divider | Arduino Pin A3 | Gold / Yellow | 0V – 3.67V Analog | Solar panel monitor (Vsolar / 6.000). Harvesting > 12.0V.

#### ⚡ Golden Rules for Test 06 Assembly

- 1. Calibrate Buck Converter First: Adjust LM2596 brass screw to 5.00V ± 0.05V before connecting to Arduino.
- 2. Verify Voltage Dividers: Ensure 100k/33k (A2) and 100k/20k (A3) dividers are properly installed to prevent over-voltage damage to Arduino analog inputs.
- 3. Serial Monitor Test: Upload 06_solar_charger_battery_test.ino and open Serial Monitor at 115200 baud to view real-time solar harvesting and battery state telemetry.
