Glenn-IT/WBACFSPWI-Web-Based-Automatic-Controller-for-Solar-Powered-Water-Irrigation/arduino/07_dual_sensor_pump_integration_test/wiring_guide.html

Star Wiring Test 07

# Dual Sensor (Capacitive + HW-080) & Relay Pump Integration

Main Power: 3S Battery + Buck (5.0V) | Star Wiring Topology | Autonomous Rice Irrigation with 3-Layer Safety Net

🏠 Master Hub Test 01: Root Soil Test 02: HW-080 Surface Test 03: Relay & Pump Test 04: Battery Monitor Test 05: Solar Monitor Test 06: Solar Charger Test 07: Dual Sensor Test 08: 12V Presentation 📡 Test 09: ESP8266 WiFi 📱 Test 10: GSM SMS Alert 🚀 Full Controller

🌾 Autonomous Rice Field Control Logic (Calibrated 3-Point System)

This integrated test verifies real-world closed-loop irrigation: The pump turns ON when surface standing water drops below 45.0% (Refill threshold) and turns OFF when water reaches 50.0% (Target depth). It includes a 5-second anti-splash minimum runtime to ignore ripples and a 10-second wave settling stabilization window before confirming target attainment.

⚡

Interactive Breadboard & Star Wiring Schematic (Click wires to highlight)

Red: Star 5.0V Power Rail

Blue: Star Common Ground (0V)

Pink: D8 Power Gate Signal

Green: A0 Capacitive Soil Signal

Cyan: A1 HW-080 Surface Signal

Amber: D7 Relay Active-LOW Trigger

Purple: 12V Battery Power to Relay COM

📋

Dual Sensor & Relay Pump Breadboard Wiring Matrix

Wire ID | Origin Node (From) | Breadboard Tie-Point | Destination Node (To) | Wire Color | Signal / Voltage | Function & Safety Rule
PWR-01 | 3S Battery (+) [11.1V–12.6V] | Direct Wire | LM2596 Buck IN+ | Red | 11.1V–12.6V DC | Battery feed into LM2596 step-down converter.
PWR-02 | LM2596 Buck OUT+ | Top Red Rail (+) | Arduino 5V Pin | Red | 5.00V DC Regulated | Supplies clean regulated 5.00V logic power to Arduino ATmega328P.
PWR-03 | Top Red Rail (+) | Direct Jumper | 5V Relay Module VCC | Red | 5.00V DC | Powers relay optocoupler coil driver circuitry.
PWR-04 | Top Red Rail (+) | Direct Jumper | HW-080 Driver VCC | Red | 5.00V DC | Powers LM393 surface water comparator driver board.
GND-01 | LM2596 Buck OUT- | Top Blue Rail (-) | Arduino GND Pin | Blue / Slate | 0.00V (Star GND) | Central zero-volt ground reference for logic and analog pins.
GND-02 | 3S Battery (-) Terminal | Top Blue Rail (-) | Buck IN- Terminal | Blue / Black | 0.00V (Common) | Ties battery negative return directly into central star ground.
GND-03 | Relay GND & Sensors GND | Top Blue Rail (-) | Star Common GND | Blue / Slate | 0.00V | Ground returns for relay coil, capacitive sensor, and HW-080.
ACT-01 | 3S Battery (+) [11.1V–12.6V] | Direct Heavy Wire | Relay COM Terminal | Purple / Red | 11.1V–12.6V High Current | Feeds raw un-stepped battery power to relay switch contacts.
ACT-02 | Relay NO Terminal | Row 35 (Diode Cathode) | DC Pump (+) Lead | Blue | Switched 12V DC | Powers water pump motor when relay is engaged.
ACT-03 | DC Pump (-) Lead | Row 40 (Diode Anode) | Star GND Rail (-) | Blue / Black | Motor Return GND | Motor return current flows into Star GND, bypassing Arduino MCU.
ACT-04 | Row 35 (Cathode) | 1N4007 Diode Body | Row 40 (Anode) | Diode Component | Flyback Clamp | Inductive Spike Suppression: Clamps reverse-EMF kickback.
SIG-01 | Arduino Pin D7 | Direct Jumper | Relay IN Pin | Amber | 5V Digital Out | Active LOW trigger with 3-minute continuous runtime safety cap.
SIG-02 | Arduino Pin D8 | Direct Jumper | Capacitive Sensor VCC | Pink / Red | 5V Digital Gate | Powers capacitive sensor only during sampling (anti-corrosion).
SIG-03 | Capacitive Sensor AOUT | Direct Jumper | Arduino Pin A0 | Green | 0V – 3.0V Analog | Root zone soil moisture reading (Air ~417, Water ~153).
SIG-04 | HW-080 Sensor AO | Direct Jumper | Arduino Pin A1 | Cyan | 0V – 5.0V Analog | Surface ponding depth controller (Dry=1020, Mid=663, Full=568). Maintains 50.0% target layer (Target 50.0%, Refill min 45.0%).

#### 🌾 Autonomous Verification Sequence

- 1. Power-Up Stabilization: On boot, Arduino blinks Pin 13 LED for 10 seconds to allow sensor power rails to settle before making irrigation decisions.
- 2. Refill Test (< 45.0%): Hold HW-080 dry in air. Pump relay clicks ON. Pin 13 LED illuminates.
- 3. Anti-Splash Test (5s): Submerging probe within 5 seconds will NOT immediately stop pump; the 5000ms minimum runtime guarantees anti-splash ripple immunity.
- 4. Settling Window Test (10s): Once probe is submerged to ≥ 50.0% after 5s runtime, pump clicks OFF and system enters a 10-second wave settling delay before logging stable state.
