Glenn-IT/WBACFSPWI-Web-Based-Automatic-Controller-for-Solar-Powered-Water-Irrigation/arduino/08_dc_adapter_presentation_test/wiring_guide.html

Star Wiring Test 08

# 12V DC Power Adapter & 5A Step-Down Module

Direct Current Presentation Mode | Plug & Play 12V Adapter | Fixed 5.0V Buck Output | Dual Sensors & 12V DC Pump

🏠 Master Hub Test 01: Root Soil Test 02: HW-080 Surface Test 03: Relay & Pump Test 04: Battery Monitor Test 05: Solar Monitor Test 06: Solar Charger Test 07: Dual Sensor Test 08: 12V Presentation 📡 Test 09: ESP8266 WiFi 📱 Test 10: GSM SMS Alert 🚀 Full Controller

⚡

Interactive Star Breadboard Diagram (12V Adapter + 5A Step-Down Module + Sensors & Pump)

📊

Star Wiring & Power Architecture Reference Table

From (Origin Node) | Breadboard Star Node | Destination Component | Wire Color | Power / Signal Role
12V Power Adapter | Direct DC Barrel Jack | 5A Step-Down Module | Barrel Plug | Primary DC Supply: 12.0V DC regulated wall power.
Module IN+ (12V) | Direct Wire | Relay COM Terminal | Pink / Red | Raw 12V Pass-Through: Feeds full 12V directly to relay contact.
Module IN- (GND) | Star GND Blue Rail (-) | Common Ground | Black / Slate | Ties adapter ground return directly into central star ground.
Module 5V+ OUT | Star 5V Red Rail (+) | Arduino 5V, Relay VCC, HW080 VCC | Red | Logic Supply: Clean, fixed 5.00V DC regulated power (up to 5A).
Module GND OUT | Star GND Blue Rail (-) | Arduino GND & Sensors GND | Black / Slate | Star Ground Reference: Central 0V reference eliminating sensor noise.
Arduino Pin D7 | Direct Jumper | Relay IN Terminal | Amber | Active LOW 5V control pulse triggering 12V pump relay.
Arduino Pin D8 | Direct Jumper | Capacitive Sensor VCC | Pink | Anti-Corrosion Gate: Powers sensor only during 50ms read cycle.
Capacitive Sensor AOUT | Direct Jumper | Arduino Pin A0 | Green | Analog root zone soil moisture telemetry (0V–3.0V).
HW-080 Sensor AO | Direct Jumper | Arduino Pin A1 | Cyan | Analog surface water ponding level (0V–5.0V).
Relay NO Terminal | Row 20 (Diode Cathode) | DC Pump (+) Lead | Blue | Switched 12V DC power to pump motor with flyback diode clamp.
Star GND Rail | Row 25 (Diode Anode) | DC Pump (-) Return | Black / Slate | Motor ground return path returning directly to Star GND rail.

#### ⚡ Star Wiring & Presentation Mode Architecture

Main Power: 12V DC Power Adapter + 5A Step-Down Module (Fixed 5.00V) powers the entire system with unlimited runtime.
Isolated Motor Current: Motor return current flows strictly through Breadboard Row 20 & 25 back to Star GND, completely isolating the Arduino ATmega328P microcontroller from motor noise and inductive spikes.
USB Connection: Used only as a Serial Data Bridge (115200 baud) for live evaluation telemetry.

⌨️

Live Serial Console Interactive Commands (115200 Baud)

Key | Action | Presentation / Defense Purpose
1 | 5-Second Safe Demo Pulse | Runs the 12V water pump for exactly 5 seconds, then automatically stops to prevent water spills on your presentation table.
0 | Emergency Stop | Immediately de-energizes the relay and turns the water pump off.
A | Autonomous Irrigation Mode | Auto-controls the pump based on HW-080 ponding level (Refills when <75%, Stops when ≥80%).
M | Manual Standby Mode | Disables automatic pumping so you can dip sensors into test cups without sudden motor activation.
T | 5-Second Hardware Self-Test | Tests both analog sensors and clicks the relay once to confirm circuit integrity for the panel.
S | Status Summary Card | Prints a formatted snapshot card of all sensor percentages and raw ADC readings.

🎯

Step-by-Step Presentation Procedure

1. Plug In 12V Power Adapter: Plug the adapter into the wall and connect the barrel plug directly into the module's DC jack.
2. Connect USB Data Cable: Connect the Arduino Uno to your laptop/PC and open the Serial Monitor at 115200 baud.
3. Test Soil Sensor (Air vs Soil/Water): Hold the capacitive sensor probe in air (0%) and then dip it into moist soil or a cup of water (70–80%).
4. Test HW-080 Water Level Sensor: Submerge the probe in water and observe the live ASCII gauge bar fill up on screen in real time.
5. Demonstrate Automated Pump Trigger: Switch to Auto Mode (A) and lift the sensor out of the water to demonstrate automated pump refilling.
