Glenn-IT/WBACFSPWI-Web-Based-Automatic-Controller-for-Solar-Powered-Water-Irrigation/arduino/09_esp8266_wifi_bridge_test/wiring_guide.html

Hardware Verification Test 09

# NodeMCU ESP8266MOD WiFi Bridge Wiring Guide

Complete High-Visibility Breadboard Schematic: Arduino Uno R3 + NodeMCU ESP-12E (CP2102) | 5V-to-3.3V Logic Shifting | Star Power Distribution | Wireless Web Integration

🏠 Master Hub Test 01: Root Soil Test 02: HW-080 Surface Test 03: Relay & Pump Test 04: Battery Monitor Test 05: Solar Monitor Test 06: Solar Charger Test 07: Dual Sensor Test 08: 12V Presentation 📡 Test 09: ESP8266 WiFi 📱 Test 10: GSM SMS Alert 🚀 Full Controller

📡

Interactive Star Breadboard Diagram (NodeMCU ESP8266MOD WiFi Serial Bridge)

Star 5.0V Logic Power (Red)

Star Common Ground 0V (Blue)

Arduino D10 5V TX Output (Amber)

Level-Shifted 3.33V Tap → NodeMCU D1 RX (Emerald)

NodeMCU D2 3.3V TX → Arduino D9 RX (Cyan)

📊

Pin-by-Pin Star Breadboard Connection Matrix

Wire ID | Origin Node (From) | Breadboard Routing | Destination Node (To) | Wire Color | Logic / Voltage | Engineering Notes
PWR-01 | LM2596 Buck OUT+ | Top Red Rail (+) | Arduino 5V Pin | Red | 5.00V DC Regulated | Main logic power supply to Arduino ATmega328P MCU.
PWR-02 | Top Red Rail (+) | Direct Jumper | NodeMCU Pin Vin | Red | 5.00V DC Regulated | Feeds NodeMCU onboard AMS1117-3.3 regulator to power ESP8266 and WiFi radio.
GND-01 | LM2596 Buck OUT- | Top Blue Rail (-) | Arduino GND Pin | Blue / Slate | 0.00V (Star GND) | Establishes the central zero-volt ground reference for all components.
GND-02 | Top Blue Rail (-) | Direct Jumper | NodeMCU Pin GND | Blue / Black | 0.00V (Star GND) | Common ground return preventing ground loops and floating logic levels.
GND-03 | Row 25 (2kΩ Ground) | Direct Jumper | Top Blue Rail (-) | Blue | 0.00V Reference | Ground leg of the 1kΩ / 2kΩ logic level shifting voltage divider.
SIG-01 | Arduino Pin D10 (TX) | Row 15 (1kΩ Input) | 1kΩ Resistor Body | Amber / Gold | 5.0V TTL Logic | High-speed SoftwareSerial TX line from Arduino. Must NOT be wired directly to ESP.
SIG-02 | Row 20 (R1/R2 Junction) | 1kΩ / 2kΩ Resistor Divider | NodeMCU Pin D1 (RX) | Emerald Green | 3.33V Stepped Down | Level Shifted: 5V dropped to 3.33V safe for ESP8266 GPIO5 silicon input.
SIG-03 | NodeMCU Pin D2 (TX) | Row 30 Direct Jumper | Arduino Pin D9 (RX) | Cyan | 3.3V Digital (Safe) | NodeMCU 3.3V TX directly triggers Arduino 5V TTL input HIGH (≥ 3.0V threshold).

#### ⚡ Golden Rules for Error-Free Assembly

- 1. Never Connect Arduino 5V TX Directly to ESP8266 RX: The ESP8266 silicon pins are strictly 3.3V rated. Always route Arduino Pin D10 through the 1kΩ / 2kΩ voltage divider into NodeMCU Pin D1.
- 2. Star Ground Bus Is Mandatory: Both Arduino GND and NodeMCU GND must terminate on the central breadboard blue ground bus. Without this common reference, UART serial bytes will arrive corrupted.
- 3. Feed Power into Vin, Never 3V3: The LM2596 output is 5.00V. Feed this 5.00V into NodeMCU pin Vin (which utilizes the onboard AMS1117-3.3 regulator). Connecting 5V directly to the 3V3 pin will destroy the ESP8266 module instantly!
- 4. SoftwareSerial Baud Alignment: Both Arduino Uno sketch and NodeMCU bridge sketch communicate at 9600 baud. This guarantees 100% stable packet reception on Uno's software bit-banging serial pins without dropped bytes.

🛠️

Step-by-Step Hardware Verification Sequence

1. Set and Verify 5.00V Buck Power: Disconnect Arduino and NodeMCU. Apply 12V DC input to LM2596. Use a digital multimeter on OUT+ and OUT- to verify exactly 5.00V ± 0.05V before plugging into breadboard power rails.
2. Assemble the 1kΩ / 2kΩ Voltage Divider on Breadboard: Insert 1kΩ resistor between Row 15 and Row 20. Insert 2kΩ resistor between Row 20 and Row 25. Connect a blue jumper from Row 25 to the top blue Star Ground rail.
3. Wire Arduino & NodeMCU Serial Lines: Connect Arduino Pin D10 to Breadboard Row 15. Connect Breadboard Row 20 (the 3.33V center tap) to NodeMCU Pin D1 (GPIO5 / RX). Connect NodeMCU Pin D2 (GPIO4 / TX) directly to Arduino Pin D9 (RX).
4. Connect Star Power Rails: Run red jumper from Star 5V Rail to Arduino 5V and another to NodeMCU Vin. Run blue jumpers from Star GND Rail to Arduino GND and NodeMCU GND.
5. Upload Firmware & Test Live: Upload wbacfspwi_arduino_controller.ino to Arduino Uno. Upload 09_esp8266_wifi_bridge_test.ino to NodeMCU via micro-USB. Open Serial Monitor at 115200 baud to observe telemetry packets transmitted wirelessly over WiFi.

💻

Software Verification & API Endpoint Testing

Test Stage | Verification Command / URL | Expected Response
1. WiFi Connection | Check NodeMCU Serial Monitor (115200 baud) during boot | [WIFI] Connected! IP: 192.168.x.x | RSSI: -54 dBm
2. Serial Bridge Ingestion | Observe Arduino streaming JSON telemetry over D9/D10 at 9600 baud | [ESP-BRIDGE] RX from Uno: {"soil_raw":417,"water_raw":410...}
3. REST HTTP Telemetry Push | POST http://<server-ip>/api/device/report.php | HTTP 200 OK: {"status":"ok","alerts_created":[]}
4. Remote Override Ingestion | GET http://<server-ip>/api/device/pull-schedule.php | HTTP 200 OK: {"schedules":[...],"overrides":[...]}
