Glenn-IT/WBACFSPWI-Web-Based-Automatic-Controller-for-Solar-Powered-Water-Irrigation/arduino/07_dual_sensor_pump_integration_test/output.md

[LIVE TELEMETRY] Root Moisture: 15.5% (Capacitive Data) | Surface Water: 0.8% (HW-080 Control) | Pump Relay: RUNNING (ON for 62s) | Decision: IRRIGATING PADDY (Filling until surface water reaches 85.0%)
==================================================================
 WBACFSPWI: Dual Sensor & Relay Pump Integrated Controller Test  
==================================================================
Paddy Water Control Rules (HW-080 Surface Driven):
  - PUMP ON : Surface Water <= 30.0% (Water level low)
  - PUMP OFF: Surface Water >= 85.0% (Paddy flooded / target reached)
  - Capacitive Soil Sensor: Telemetry/Data Monitoring Only (0-100%)
==================================================================
>>> [ACTION] PUMP STARTED | Reason: Surface Water Level Low (<= 30.0%)
[LIVE TELEMETRY] Root Moisture: 21.6% (Capacitive Data) | Surface Water: 0.0% (HW-080 Control) | Pump Relay: RUNNING (ON for 0s) | Decision: IRRIGATING PADDY (Filling until surface water reaches 85.0%)
[LIVE TELEMETRY] Root Moisture: 14.0% (Capacitive Data) | Surface Water: 1.0% (HW-080 Control) | Pump Relay: RUNNING (ON for 1s) | Decision: IRRIGATING PADDY (Filling until surface water reaches 85.0%)
[LIVE TELEMETRY] Root Moisture: 13.3% (Capacitive Data) | Surface Water: 1.0% (HW-080 Control) | Pump Relay: RUNNING (ON for 2s) | Decision: IRRIGATING PADDY (Filling until surface water reaches 85.0%)
[LIVE TELEMETRY] Root Moisture: 13.3% (Capacitive Data) | Surface Water: 1.0% (HW-080 Control) | Pump Relay: RUNNING (ON for 3s) | Decision: IRRIGATING PADDY (Filling until surface water reaches 85.0%)
[LIVE TELEMETRY] Root Moisture: 38.3% (Capacitive Data) | Surface Water: 1.0% (HW-080 Control) | Pump Relay: RUNNING (ON for 4s) | Decision: IRRIGATING PADDY (Filling until surface water reaches 85.0%)
[LIVE TELEMETRY] Root Moisture: 56.1% (Capacitive Data) | Surface Water: 1.0% (HW-080 Control) | Pump Relay: RUNNING (ON for 6s) | Decision: IRRIGATING PADDY (Filling until surface water reaches 85.0%)
[LIVE TELEMETRY] Root Moisture: 67.8% (Capacitive Data) | Surface Water: 1.0% (HW-080 Control) | Pump Relay: RUNNING (ON for 7s) | Decision: IRRIGATING PADDY (Filling until surface water reaches 85.0%)
[LIVE TELEMETRY] Root Moisture: 73.9% (Capacitive Data) | Surface Water: 1.0% (HW-080 Control) | Pump Relay: RUNNING (ON for 8s) | Decision: IRRIGATING PADDY (Filling until surface water reaches 85.0%)
[LIVE TELEMETRY] Root Moisture: 78.4% (Capacitive Data) | Surface Water: 1.0% (HW-080 Control) | Pump Relay: RUNNING (ON for 9s) | Decision: IRRIGATING PADDY (Filling until surface water reaches 85.0%)
[LIVE TELEMETRY] Root Moisture: 79.9% (Capacitive Data) | Surface Water: 0.8% (HW-080 Control) | Pump Relay: RUNNING (ON for 11s) | Decision: IRRIGATING PADDY (Filling until surface water reaches 85.0%)
[LIVE TELEMETRY] Root Moisture: 82.2% (Capacitive Data) | Surface Water: 1.0% (HW-080 Control) | Pump Relay: RUNNING (ON for 12s) | Decision: IRRIGATING PADDY (Filling until surface water reaches 85.0%)
[LIVE TELEMETRY] Root Moisture: 83.7% (Capacitive Data) | Surface Water: 0.8% (HW-080 Control) | Pump Relay: RUNNING (ON for 13s) | Decision: IRRIGATING PADDY (Filling until surface water reaches 85.0%)
[LIVE TELEMETRY] Root Moisture: 84.8% (Capacitive Data) | Surface Water: 1.0% (HW-080 Control) | Pump Relay: RUNNING (ON for 14s) | Decision: IRRIGATING PADDY (Filling until surface water reaches 85.0%)
[LIVE TELEMETRY] Root Moisture: 86.4% (Capacitive Data) | Surface Water: 1.2% (HW-080 Control) | Pump Relay: RUNNING (ON for 15s) | Decision: IRRIGATING PADDY (Filling until surface water reaches 85.0%)
[LIVE TELEMETRY] Root Moisture: 86.4% (Capacitive Data) | Surface Water: 1.0% (HW-080 Control) | Pump Relay: RUNNING (ON for 17s) | Decision: IRRIGATING PADDY (Filling until surface water reaches 85.0%)
[LIVE TELEMETRY] Root Moisture: 86.7% (Capacitive Data) | Surface Water: 1.0% (HW-080 Control) | Pump Relay: RUNNING (ON for 18s) | Decision: IRRIGATING PADDY (Filling until surface water reaches 85.0%)
[LIVE TELEMETRY] Root Moisture: 86.7% (Capacitive Data) | Surface Water: 1.4% (HW-080 Control) | Pump Relay: RUNNING (ON for 19s) | Decision: IRRIGATING PADDY (Filling until surface water reaches 85.0%)
[LIVE TELEMETRY] Root Moisture: 86.7% (Capacitive Data) | Surface Water: 1.0% (HW-080 Control) | Pump Relay: RUNNING (ON for 20s) | Decision: IRRIGATING PADDY (Filling until surface water reaches 85.0%)
[LIVE TELEMETRY] Root Moisture: 87.9% (Capacitive Data) | Surface Water: 1.0% (HW-080 Control) | Pump Relay: RUNNING (ON for 22s) | Decision: IRRIGATING PADDY (Filling until surface water reaches 85.0%)
[LIVE TELEMETRY] Root Moisture: 89.4% (Capacitive Data) | Surface Water: 1.2% (HW-080 Control) | Pump Relay: RUNNING (ON for 23s) | Decision: IRRIGATING PADDY (Filling until surface water reaches 85.0%)
[LIVE TELEMETRY] Root Moisture: 89.8% (Capacitive Data) | Surface Water: 1.2% (HW-080 Control) | Pump Relay: RUNNING (ON for 24s) | Decision: IRRIGATING PADDY (Filling until surface water reaches 85.0%)
[LIVE TELEMETRY] Root Moisture: 89.4% (Capacitive Data) | Surface Water: 1.0% (HW-080 Control) | Pump Relay: RUNNING (ON for 25s) | Decision: IRRIGATING PADDY (Filling until surface water reaches 85.0%)
[LIVE TELEMETRY] Root Moisture: 90.2% (Capacitive Data) | Surface Water: 1.0% (HW-080 Control) | Pump Relay: RUNNING (ON for 26s) | Decision: IRRIGATING PADDY (Filling until surface water reaches 85.0%)
[LIVE TELEMETRY] Root Moisture: 90.2% (Capacitive Data) | Surface Water: 1.0% (HW-080 Control) | Pump Relay: RUNNING (ON for 28s) | Decision: IRRIGATING PADDY (Filling until surface water reaches 85.0%)
[LIVE TELEMETRY] Root Moisture: 91.7% (Capacitive Data) | Surface Water: 1.0% (HW-080 Control) | Pump Relay: RUNNING (ON for 29s) | Decision: IRRIGATING PADDY (Filling until surface water reaches 85.0%)
[LIVE TELEMETRY] Root Moisture: 92.0% (Capacitive Data) | Surface Water: 53.8% (HW-080 Control) | Pump Relay: RUNNING (ON for 30s) | Decision: IRRIGATING PADDY (Filling until surface water reaches 85.0%)
[LIVE TELEMETRY] Root Moisture: 92.8% (Capacitive Data) | Surface Water: 65.6% (HW-080 Control) | Pump Relay: RUNNING (ON for 31s) | Decision: IRRIGATING PADDY (Filling until surface water reaches 85.0%)
[LIVE TELEMETRY] Root Moisture: 93.2% (Capacitive Data) | Surface Water: 77.3% (HW-080 Control) | Pump Relay: RUNNING (ON for 33s) | Decision: IRRIGATING PADDY (Filling until surface water reaches 85.0%)
[LIVE TELEMETRY] Root Moisture: 93.6% (Capacitive Data) | Surface Water: 82.8% (HW-080 Control) | Pump Relay: RUNNING (ON for 34s) | Decision: IRRIGATING PADDY (Filling until surface water reaches 85.0%)
>>> [ACTION] PUMP STOPPED | Reason: Surface Water Target Reached (>= 85.0%)
[LIVE TELEMETRY] Root Moisture: 93.9% (Capacitive Data) | Surface Water: 89.2% (HW-080 Control) | Pump Relay: STANDBY (OFF) | Decision: PONDING FULL (>= 85.0%) -> PUMP OFF
[LIVE TELEMETRY] Root Moisture: 100.0% (Capacitive Data) | Surface Water: 90.6% (HW-080 Control) | Pump Relay: STANDBY (OFF) | Decision: PONDING FULL (>= 85.0%) -> PUMP OFF
[LIVE TELEMETRY] Root Moisture: 100.0% (Capacitive Data) | Surface Water: 86.9% (HW-080 Control) | Pump Relay: STANDBY (OFF) | Decision: PONDING FULL (>= 85.0%) -> PUMP OFF
[LIVE TELEMETRY] Root Moisture: 100.0% (Capacitive Data) | Surface Water: 84.5% (HW-080 Control) | Pump Relay: STANDBY (OFF) | Decision: OPTIMAL WATER LEVEL (30% - 85%) -> STANDBY
[LIVE TELEMETRY] Root Moisture: 100.0% (Capacitive Data) | Surface Water: 81.8% (HW-080 Control) | Pump Relay: STANDBY (OFF) | Decision: OPTIMAL WATER LEVEL (30% - 85%) -> STANDBY
[LIVE TELEMETRY] Root Moisture: 100.0% (Capacitive Data) | Surface Water: 78.9% (HW-080 Control) | Pump Relay: STANDBY (OFF) | Decision: OPTIMAL WATER LEVEL (30% - 85%) -> STANDBY
[LIVE TELEMETRY] Root Moisture: 100.0% (Capacitive Data) | Surface Water: 75.5% (HW-080 Control) | Pump Relay: STANDBY (OFF) | Decision: OPTIMAL WATER LEVEL (30% - 85%) -> STANDBY
[LIVE TELEMETRY] Root Moisture: 100.0% (Capacitive Data) | Surface Water: 72.8% (HW-080 Control) | Pump Relay: STANDBY (OFF) | Decision: OPTIMAL WATER LEVEL (30% - 85%) -> STANDBY
[LIVE TELEMETRY] Root Moisture: 100.0% (Capacitive Data) | Surface Water: 70.1% (HW-080 Control) | Pump Relay: STANDBY (OFF) | Decision: OPTIMAL WATER LEVEL (30% - 85%) -> STANDBY
[LIVE TELEMETRY] Root Moisture: 99.6% (Capacitive Data) | Surface Water: 68.7% (HW-080 Control) | Pump Relay: STANDBY (OFF) | Decision: OPTIMAL WATER LEVEL (30% - 85%) -> STANDBY
[LIVE TELEMETRY] Root Moisture: 100.0% (Capacitive Data) | Surface Water: 67.5% (HW-080 Control) | Pump Relay: STANDBY (OFF) | Decision: OPTIMAL WATER LEVEL (30% - 85%) -> STANDBY
[LIVE TELEMETRY] Root Moisture: 99.6% (Capacitive Data) | Surface Water: 66.5% (HW-080 Control) | Pump Relay: STANDBY (OFF) | Decision: OPTIMAL WATER LEVEL (30% - 85%) -> STANDBY
[LIVE TELEMETRY] Root Moisture: 99.6% (Capacitive Data) | Surface Water: 66.3% (HW-080 Control) | Pump Relay: STANDBY (OFF) | Decision: OPTIMAL WATER LEVEL (30% - 85%) -> STANDBY
[LIVE TELEMETRY] Root Moisture: 99.6% (Capacitive Data) | Surface Water: 65.6% (HW-080 Control) | Pump Relay: STANDBY (OFF) | Decision: OPTIMAL WATER LEVEL (30% - 85%) -> STANDBY
[LIVE TELEMETRY] Root Moisture: 99.6% (Capacitive Data) | Surface Water: 65.0% (HW-080 Control) | Pump Relay: STANDBY (OFF) | Decision: OPTIMAL WATER LEVEL (30% - 85%) -> STANDBY
[LIVE TELEMETRY] Root Moisture: 99.6% (Capacitive Data) | Surface Water: 64.0% (HW-080 Control) | Pump Relay: STANDBY (OFF) | Decision: OPTIMAL WATER LEVEL (30% - 85%) -> STANDBY
[LIVE TELEMETRY] Root Moisture: 99.6% (Capacitive Data) | Surface Water: 63.6% (HW-080 Control) | Pump Relay: STANDBY (OFF) | Decision: OPTIMAL WATER LEVEL (30% - 85%) -> STANDBY
[LIVE TELEMETRY] Root Moisture: 99.6% (Capacitive Data) | Surface Water: 63.2% (HW-080 Control) | Pump Relay: STANDBY (OFF) | Decision: OPTIMAL WATER LEVEL (30% - 85%) -> STANDBY
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
[LIVE TELEMETRY] Root Moisture: 99.2% (Capacitive Data) | Surface Water: 40.5% (HW-080 Control) | Pump Relay: STANDBY (OFF) | Decision: OPTIMAL WATER LEVEL (30% - 85%) -> STANDBY
[LIVE TELEMETRY] Root Moisture: 99.2% (Capacitive Data) | Surface Water: 39.9% (HW-080 Control) | Pump Relay: STANDBY (OFF) | Decision: OPTIMAL WATER LEVEL (30% - 85%) -> STANDBY
[LIVE TELEMETRY] Root Moisture: 99.2% (Capacitive Data) | Surface Water: 39.3% (HW-080 Control) | Pump Relay: STANDBY (OFF) | Decision: OPTIMAL WATER LEVEL (30% - 85%) -> STANDBY
[LIVE TELEMETRY] Root Moisture: 98.9% (Capacitive Data) | Surface Water: 38.4% (HW-080 Control) | Pump Relay: STANDBY (OFF) | Decision: OPTIMAL WATER LEVEL (30% - 85%) -> STANDBY
[LIVE TELEMETRY] Root Moisture: 99.2% (Capacitive Data) | Surface Water: 38.0% (HW-080 Control) | Pump Relay: STANDBY (OFF) | Decision: OPTIMAL WATER LEVEL (30% - 85%) -> STANDBY
[LIVE TELEMETRY] Root Moisture: 98.9% (Capacitive Data) | Surface Water: 37.4% (HW-080 Control) | Pump Relay: STANDBY (OFF) | Decision: OPTIMAL WATER LEVEL (30% - 85%) -> STANDBY
[LIVE TELEMETRY] Root Moisture: 98.9% (Capacitive Data) | Surface Water: 36.6% (HW-080 Control) | Pump Relay: STANDBY (OFF) | Decision: OPTIMAL WATER LEVEL (30% - 85%) -> STANDBY
[LIVE TELEMETRY] Root Moisture: 98.9% (Capacitive Data) | Surface Water: 35.4% (HW-080 Control) | Pump Relay: STANDBY (OFF) | Decision: OPTIMAL WATER LEVEL (30% - 85%) -> STANDBY
[LIVE TELEMETRY] Root Moisture: 98.9% (Capacitive Data) | Surface Water: 34.8% (HW-080 Control) | Pump Relay: STANDBY (OFF) | Decision: OPTIMAL WATER LEVEL (30% - 85%) -> STANDBY
[LIVE TELEMETRY] Root Moisture: 98.9% (Capacitive Data) | Surface Water: 34.2% (HW-080 Control) | Pump Relay: STANDBY (OFF) | Decision: OPTIMAL WATER LEVEL (30% - 85%) -> STANDBY
[LIVE TELEMETRY] Root Moisture: 98.9% (Capacitive Data) | Surface Water: 33.3% (HW-080 Control) | Pump Relay: STANDBY (OFF) | Decision: OPTIMAL WATER LEVEL (30% - 85%) -> STANDBY
[LIVE TELEMETRY] Root Moisture: 98.9% (Capacitive Data) | Surface Water: 31.9% (HW-080 Control) | Pump Relay: STANDBY (OFF) | Decision: OPTIMAL WATER LEVEL (30% - 85%) -> STANDBY
[LIVE TELEMETRY] Root Moisture: 98.9% (Capacitive Data) | Surface Water: 31.7% (HW-080 Control) | Pump Relay: STANDBY (OFF) | Decision: OPTIMAL WATER LEVEL (30% - 85%) -> STANDBY
[LIVE TELEMETRY] Root Moisture: 98.9% (Capacitive Data) | Surface Water: 30.5% (HW-080 Control) | Pump Relay: STANDBY (OFF) | Decision: OPTIMAL WATER LEVEL (30% - 85%) -> STANDBY
>>> [ACTION] PUMP STARTED | Reason: Surface Water Level Low (<= 30.0%)
[LIVE TELEMETRY] Root Moisture: 98.9% (Capacitive Data) | Surface Water: 29.4% (HW-080 Control) | Pump Relay: RUNNING (ON for 0s) | Decision: IRRIGATING PADDY (Filling until surface water reaches 85.0%)
[LIVE TELEMETRY] Root Moisture: 90.5% (Capacitive Data) | Surface Water: 40.1% (HW-080 Control) | Pump Relay: RUNNING (ON for 1s) | Decision: IRRIGATING PADDY (Filling until surface water reaches 85.0%)
[LIVE TELEMETRY] Root Moisture: 90.9% (Capacitive Data) | Surface Water: 52.8% (HW-080 Control) | Pump Relay: RUNNING (ON for 2s) | Decision: IRRIGATING PADDY (Filling until surface water reaches 85.0%)
[LIVE TELEMETRY] Root Moisture: 92.0% (Capacitive Data) | Surface Water: 75.1% (HW-080 Control) | Pump Relay: RUNNING (ON for 3s) | Decision: IRRIGATING PADDY (Filling until surface water reaches 85.0%)
[LIVE TELEMETRY] Root Moisture: 92.0% (Capacitive Data) | Surface Water: 81.4% (HW-080 Control) | Pump Relay: RUNNING (ON for 4s) | Decision: IRRIGATING PADDY (Filling until surface water reaches 85.0%)
>>> [ACTION] PUMP STOPPED | Reason: Surface Water Target Reached (>= 85.0%)
[LIVE TELEMETRY] Root Moisture: 92.4% (Capacitive Data) | Surface Water: 87.7% (HW-080 Control) | Pump Relay: STANDBY (OFF) | Decision: PONDING FULL (>= 85.0%) -> PUMP OFF
[LIVE TELEMETRY] Root Moisture: 100.0% (Capacitive Data) | Surface Water: 87.9% (HW-080 Control) | Pump Relay: STANDBY (OFF) | Decision: PONDING FULL (>= 85.0%) -> PUMP OFF
[LIVE TELEMETRY] Root Moisture: 100.0% (Capacitive Data) | Surface Water: 84.0% (HW-080 Control) | Pump Relay: STANDBY (OFF) | Decision: OPTIMAL WATER LEVEL (30% - 85%) -> STANDBY
[LIVE TELEMETRY] Root Moisture: 100.0% (Capacitive Data) | Surface Water: 80.8% (HW-080 Control) | Pump Relay: STANDBY (OFF) | Decision: OPTIMAL WATER LEVEL (30% - 85%) -> STANDBY
[LIVE TELEMETRY] Root Moisture: 100.0% (Capacitive Data) | Surface Water: 76.7% (HW-080 Control) | Pump Relay: STANDBY (OFF) | Decision: OPTIMAL WATER LEVEL (30% - 85%) -> STANDBY
[LIVE TELEMETRY] Root Moisture: 99.6% (Capacitive Data) | Surface Water: 72.8% (HW-080 Control) | Pump Relay: STANDBY (OFF) | Decision: OPTIMAL WATER LEVEL (30% - 85%) -> STANDBY
[LIVE TELEMETRY] Root Moisture: 99.6% (Capacitive Data) | Surface Water: 69.9% (HW-080 Control) | Pump Relay: STANDBY (OFF) | Decision: OPTIMAL WATER LEVEL (30% - 85%) -> STANDBY
[LIVE TELEMETRY] Root Moisture: 99.6% (Capacitive Data) | Surface Water: 68.1% (HW-080 Control) | Pump Relay: STANDBY (OFF) | Decision: OPTIMAL WATER LEVEL (30% - 85%) -> STANDBY
[LIVE TELEMETRY] Root Moisture: 99.6% (Capacitive Data) | Surface Water: 66.9% (HW-080 Control) | Pump Relay: STANDBY (OFF) | Decision: OPTIMAL WATER LEVEL (30% - 85%) -> STANDBY
[LIVE TELEMETRY] Root Moisture: 99.2% (Capacitive Data) | Surface Water: 66.3% (HW-080 Control) | Pump Relay: STANDBY (OFF) | Decision: OPTIMAL WATER LEVEL (30% - 85%) -> STANDBY
[LIVE TELEMETRY] Root Moisture: 99.6% (Capacitive Data) | Surface Water: 65.8% (HW-080 Control) | Pump Relay: STANDBY (OFF) | Decision: OPTIMAL WATER LEVEL (30% - 85%) -> STANDBY
[LIVE TELEMETRY] Root Moisture: 99.6% (Capacitive Data) | Surface Water: 65.4% (HW-080 Control) | Pump Relay: STANDBY (OFF) | Decision: OPTIMAL WATER LEVEL (30% - 85%) -> STANDBY
[LIVE TELEMETRY] Root Moisture: 99.6% (Capacitive Data) | Surface Water: 65.0% (HW-080 Control) | Pump Relay: STANDBY (OFF) | Decision: OPTIMAL WATER LEVEL (30% - 85%) -> STANDBY
[LIVE TELEMETRY] Root Moisture: 99.2% (Capacitive Data) | Surface Water: 64.4% (HW-080 Control) | Pump Relay: STANDBY (OFF) | Decision: OPTIMAL WATER LEVEL (30% - 85%) -> STANDBY
[LIVE TELEMETRY] Root Moisture: 99.6% (Capacitive Data) | Surface Water: 63.6% (HW-080 Control) | Pump Relay: STANDBY (OFF) | Decision: OPTIMAL WATER LEVEL (30% - 85%) -> STANDBY
[LIVE TELEMETRY] Root Moisture: 99.6% (Capacitive Data) | Surface Water: 63.8% (HW-080 Control) | Pump Relay: STANDBY (OFF) | Decision: OPTIMAL WATER LEVEL (30% - 85%) -> STANDBY
[LIVE TELEMETRY] Root Moisture: 99.6% (Capacitive Data) | Surface Water: 63.4% (HW-080 Control) | Pump Relay: STANDBY (OFF) | Decision: OPTIMAL WATER LEVEL (30% - 85%) -> STANDBY
[LIVE TELEMETRY] Root Moisture: 99.2% (Capacitive Data) | Surface Water: 63.0% (HW-080 Control) | Pump Relay: STANDBY (OFF) | Decision: OPTIMAL WATER LEVEL (30% - 85%) -> STANDBY
[LIVE TELEMETRY] Root Moisture: 99.2% (Capacitive Data) | Surface Water: 62.6% (HW-080 Control) | Pump Relay: STANDBY (OFF) | Decision: OPTIMAL WATER LEVEL (30% - 85%) -> STANDBY
[LIVE TELEMETRY] Root Moisture: 99.2% (Capacitive Data) | Surface Water: 62.2% (HW-080 Control) | Pump Relay: STANDBY (OFF) | Decision: OPTIMAL WATER LEVEL (30% - 85%) -> STANDBY
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
[LIVE TELEMETRY] Root Moisture: 98.9% (Capacitive Data) | Surface Water: 37.0% (HW-080 Control) | Pump Relay: STANDBY (OFF) | Decision: OPTIMAL WATER LEVEL (30% - 85%) -> STANDBY
[LIVE TELEMETRY] Root Moisture: 98.9% (Capacitive Data) | Surface Water: 36.8% (HW-080 Control) | Pump Relay: STANDBY (OFF) | Decision: OPTIMAL WATER LEVEL (30% - 85%) -> STANDBY
>>> [ACTION] PUMP STARTED | Reason: Surface Water Level Low (<= 30.0%)
[LIVE TELEMETRY] Root Moisture: 98.9% (Capacitive Data) | Surface Water: 12.7% (HW-080 Control) | Pump Relay: RUNNING (ON for 0s) | Decision: IRRIGATING PADDY (Filling until surface water reaches 85.0%)
[LIVE TELEMETRY] Root Moisture: 89.4% (Capacitive Data) | Surface Water: 1.0% (HW-080 Control) | Pump Relay: RUNNING (ON for 1s) | Decision: IRRIGATING PADDY (Filling until surface water reaches 85.0%)
[LIVE TELEMETRY] Root Moisture: 89.4% (Capacitive Data) | Surface Water: 1.0% (HW-080 Control) | Pump Relay: RUNNING (ON for 2s) | Decision: IRRIGATING PADDY (Filling until surface water reaches 85.0%)
[LIVE TELEMETRY] Root Moisture: 88.6% (Capacitive Data) | Surface Water: 1.0% (HW-080 Control) | Pump Relay: RUNNING (ON for 3s) | Decision: IRRIGATING PADDY (Filling until surface water reaches 85.0%)
>>> [ACTION] PUMP STOPPED | Reason: Surface Water Target Reached (>= 85.0%)
[LIVE TELEMETRY] Root Moisture: 91.7% (Capacitive Data) | Surface Water: 87.7% (HW-080 Control) | Pump Relay: STANDBY (OFF) | Decision: PONDING FULL (>= 85.0%) -> PUMP OFF
[LIVE TELEMETRY] Root Moisture: 99.2% (Capacitive Data) | Surface Water: 81.0% (HW-080 Control) | Pump Relay: STANDBY (OFF) | Decision: OPTIMAL WATER LEVEL (30% - 85%) -> STANDBY
[LIVE TELEMETRY] Root Moisture: 99.2% (Capacitive Data) | Surface Water: 75.7% (HW-080 Control) | Pump Relay: STANDBY (OFF) | Decision: OPTIMAL WATER LEVEL (30% - 85%) -> STANDBY
[LIVE TELEMETRY] Root Moisture: 99.2% (Capacitive Data) | Surface Water: 69.5% (HW-080 Control) | Pump Relay: STANDBY (OFF) | Decision: OPTIMAL WATER LEVEL (30% - 85%) -> STANDBY
[LIVE TELEMETRY] Root Moisture: 99.2% (Capacitive Data) | Surface Water: 66.3% (HW-080 Control) | Pump Relay: STANDBY (OFF) | Decision: OPTIMAL WATER LEVEL (30% - 85%) -> STANDBY
[LIVE TELEMETRY] Root Moisture: 99.2% (Capacitive Data) | Surface Water: 64.2% (HW-080 Control) | Pump Relay: STANDBY (OFF) | Decision: OPTIMAL WATER LEVEL (30% - 85%) -> STANDBY
[LIVE TELEMETRY] Root Moisture: 99.2% (Capacitive Data) | Surface Water: 65.9% (HW-080 Control) | Pump Relay: STANDBY (OFF) | Decision: OPTIMAL WATER LEVEL (30% - 85%) -> STANDBY
[LIVE TELEMETRY] Root Moisture: 99.2% (Capacitive Data) | Surface Water: 63.4% (HW-080 Control) | Pump Relay: STANDBY (OFF) | Decision: OPTIMAL WATER LEVEL (30% - 85%) -> STANDBY
>>> [ACTION] PUMP STARTED | Reason: Surface Water Level Low (<= 30.0%)
[LIVE TELEMETRY] Root Moisture: 97.3% (Capacitive Data) | Surface Water: 0.6% (HW-080 Control) | Pump Relay: RUNNING (ON for 0s) | Decision: IRRIGATING PADDY (Filling until surface water reaches 85.0%)
[LIVE TELEMETRY] Root Moisture: 90.2% (Capacitive Data) | Surface Water: 0.8% (HW-080 Control) | Pump Relay: RUNNING (ON for 1s) | Decision: IRRIGATING PADDY (Filling until surface water reaches 85.0%)
[LIVE TELEMETRY] Root Moisture: 89.8% (Capacitive Data) | Surface Water: 1.0% (HW-080 Control) | Pump Relay: RUNNING (ON for 2s) | Decision: IRRIGATING PADDY (Filling until surface water reaches 85.0%)
[LIVE TELEMETRY] Root Moisture: 91.7% (Capacitive Data) | Surface Water: 1.0% (HW-080 Control) | Pump Relay: RUNNING (ON for 3s) | Decision: IRRIGATING PADDY (Filling until surface water reaches 85.0%)
>>> [ACTION] PUMP STOPPED | Reason: Surface Water Target Reached (>= 85.0%)
[LIVE TELEMETRY] Root Moisture: 92.4% (Capacitive Data) | Surface Water: 99.8% (HW-080 Control) | Pump Relay: STANDBY (OFF) | Decision: PONDING FULL (>= 85.0%) -> PUMP OFF
[LIVE TELEMETRY] Root Moisture: 99.6% (Capacitive Data) | Surface Water: 95.5% (HW-080 Control) | Pump Relay: STANDBY (OFF) | Decision: PONDING FULL (>= 85.0%) -> PUMP OFF
[LIVE TELEMETRY] Root Moisture: 100.0% (Capacitive Data) | Surface Water: 93.9% (HW-080 Control) | Pump Relay: STANDBY (OFF) | Decision: PONDING FULL (>= 85.0%) -> PUMP OFF
[LIVE TELEMETRY] Root Moisture: 100.0% (Capacitive Data) | Surface Water: 92.6% (HW-080 Control) | Pump Relay: STANDBY (OFF) | Decision: PONDING FULL (>= 85.0%) -> PUMP OFF
[LIVE TELEMETRY] Root Moisture: 100.0% (Capacitive Data) | Surface Water: 90.4% (HW-080 Control) | Pump Relay: STANDBY (OFF) | Decision: PONDING FULL (>= 85.0%) -> PUMP OFF
[LIVE TELEMETRY] Root Moisture: 100.0% (Capacitive Data) | Surface Water: 87.9% (HW-080 Control) | Pump Relay: STANDBY (OFF) | Decision: PONDING FULL (>= 85.0%) -> PUMP OFF
[LIVE TELEMETRY] Root Moisture: 100.0% (Capacitive Data) | Surface Water: 84.7% (HW-080 Control) | Pump Relay: STANDBY (OFF) | Decision: OPTIMAL WATER LEVEL (30% - 85%) -> STANDBY
[LIVE TELEMETRY] Root Moisture: 100.0% (Capacitive Data) | Surface Water: 81.8% (HW-080 Control) | Pump Relay: STANDBY (OFF) | Decision: OPTIMAL WATER LEVEL (30% - 85%) -> STANDBY
[LIVE TELEMETRY] Root Moisture: 99.6% (Capacitive Data) | Surface Water: 79.6% (HW-080 Control) | Pump Relay: STANDBY (OFF) | Decision: OPTIMAL WATER LEVEL (30% - 85%) -> STANDBY
[LIVE TELEMETRY] Root Moisture: 99.6% (Capacitive Data) | Surface Water: 78.3% (HW-080 Control) | Pump Relay: STANDBY (OFF) | Decision: OPTIMAL WATER LEVEL (30% - 85%) -> STANDBY
[LIVE TELEMETRY] Root Moisture: 99.6% (Capacitive Data) | Surface Water: 76.5% (HW-080 Control) | Pump Relay: STANDBY (OFF) | Decision: OPTIMAL WATER LEVEL (30% - 85%) -> STANDBY
[LIVE TELEMETRY] Root Moisture: 99.6% (Capacitive Data) | Surface Water: 75.3% (HW-080 Control) | Pump Relay: STANDBY (OFF) | Decision: OPTIMAL WATER LEVEL (30% - 85%) -> STANDBY
[LIVE TELEMETRY] Root Moisture: 99.6% (Capacitive Data) | Surface Water: 74.2% (HW-080 Control) | Pump Relay: STANDBY (OFF) | Decision: OPTIMAL WATER LEVEL (30% - 85%) -> STANDBY
[LIVE TELEMETRY] Root Moisture: 99.6% (Capacitive Data) | Surface Water: 73.4% (HW-080 Control) | Pump Relay: STANDBY (OFF) | Decision: OPTIMAL WATER LEVEL (30% - 85%) -> STANDBY
[LIVE TELEMETRY] Root Moisture: 99.6% (Capacitive Data) | Surface Water: 73.0% (HW-080 Control) | Pump Relay: STANDBY (OFF) | Decision: OPTIMAL WATER LEVEL (30% - 85%) -> STANDBY
[LIVE TELEMETRY] Root Moisture: 99.6% (Capacitive Data) | Surface Water: 72.8% (HW-080 Control) | Pump Relay: STANDBY (OFF) | Decision: OPTIMAL WATER LEVEL (30% - 85%) -> STANDBY
[LIVE TELEMETRY] Root Moisture: 99.6% (Capacitive Data) | Surface Water: 72.6% (HW-080 Control) | Pump Relay: STANDBY (OFF) | Decision: OPTIMAL WATER LEVEL (30% - 85%) -> STANDBY
[LIVE TELEMETRY] Root Moisture: 99.6% (Capacitive Data) | Surface Water: 72.2% (HW-080 Control) | Pump Relay: STANDBY (OFF) | Decision: OPTIMAL WATER LEVEL (30% - 85%) -> STANDBY
[LIVE TELEMETRY] Root Moisture: 99.6% (Capacitive Data) | Surface Water: 72.0% (HW-080 Control) | Pump Relay: STANDBY (OFF) | Decision: OPTIMAL WATER LEVEL (30% - 85%) -> STANDBY
[LIVE TELEMETRY] Root Moisture: 99.6% (Capacitive Data) | Surface Water: 72.0% (HW-080 Control) | Pump Relay: STANDBY (OFF) | Decision: OPTIMAL WATER LEVEL (30% - 85%) -> STANDBY
[LIVE TELEMETRY] Root Moisture: 99.6% (Capacitive Data) | Surface Water: 71.8% (HW-080 Control) | Pump Relay: STANDBY (OFF) | Decision: OPTIMAL WATER LEVEL (30% - 85%) -> STANDBY
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
[LIVE TELEMETRY] Root Moisture: 99.6% (Capacitive Data) | Surface Water: 71.0% (HW-080 Control) | Pump Relay: STANDBY (OFF) | Decision: OPTIMAL WATER LEVEL (30% - 85%) -> STANDBY
