Glenn-IT/WBACFSPWI-Web-Based-Automatic-Controller-for-Solar-Powered-Water-Irrigation/test_integration/index.html

Menu WBACFSPWI Integration Static Test

#### System Live Dashboard

Autonomous Solar-Powered Irrigation & Sensor Health Monitor

--:--:--

Auto Sim: Running

Warning message goes here

ROOT SOIL MOISTURE

42%

Optimal Moisture

Dry (<35%) Target (65%)

SURFACE PONDING

25%

Standing Depth Safe

0% Dry 80% Max Depth

3S 18650 BATTERY

11.85V

~71% Capacity

Cutoff (10.0V) Full (12.6V)

SOLAR HARVEST

17.40V

Active Solar Charging

Min Harvest (>12V) Voc (~21V)

###### Water Pump & Relay Control

AUTONOMOUS MODE

PUMP RELAY (PIN D7)

##### OFF (STANDBY)

Decision: Root moisture adequate

Current Mode: Automatic (Sensor Driven)

Continuous Runtime: 0s / 180s Max

Force Pump ON Force Pump OFF Auto

###### Active Safety Interlocks

- Low Battery Protection (>10.0V) CLEAR
- Water Ponding Overflow (<80%) CLEAR
- Pump Max Runtime Cap (180s) CLEAR

###### Live Sensor Readings (Past 10 Ticks)

Real-time Stream

###### Upcoming Schedules

#### Interactive Sensor Simulator

Manually adjust sensor values to test automated irrigation logic and safety triggers.

Reset to Defaults

Root Soil Moisture (%) 42%

0% (Air / Completely Dry) <35% PUMP ON >=65% PUMP OFF 100% (Submerged)

Surface Water Ponding Depth (%) 25%

0% (No Standing Water) 30% Normal >80% Overfill Lockout 100% Flooded

3S 18650 Battery Voltage (V) 11.85 V

9.0V <10.0V Lockout 11.1V Nominal 12.6V Full

Solar Panel Output (V) 17.40 V

0V (Night) <2V Low >12V Active Harvest ~21.6V Open Circuit

###### Quick Scenario Presets (Click to Test)

🏜️ Dry Soil (<35%) -> Auto Pump Trigger 🌿 Moist Soil (>65%) -> Auto Pump Stop 🔴 Critical Low Battery (<10V) -> Lockout 🌊 Surface Flooded (>80%) -> Lockout ☀️ Full Bright Sun (>18V) -> Solar Charging 🌙 Night Time (0V Solar) -> Battery Run

#### Irrigation Schedule Manager

Configure automated timed irrigation cycles (matches main system database schema).

Add Schedule

Status | Schedule Name | Start Time | Duration | Days Active | Action

#### System Alerts & Notifications

Real-time thresholds, warning triggers, and critical hardware condition history.

Clear All Alerts

#### Sensor Trends & Irrigation History

Chart.js multi-axis sensor tracking and downloadable CSV event logs.

Export Report (CSV)

###### 24-Hour Historical Sensor Curves

###### Irrigation Event History

Timestamp | Event Type | Trigger Reason | Duration | Water Delivered (Est.) | Status
Today 06:00:00 | Schedule #1 | Morning Rice Root Irrigation | 10 mins | ~35 Liters | Completed
Yesterday 16:30:15 | Autonomous | Root Soil Moisture < 35% | 4 mins 20s | ~15 Liters | Target 65% Met
Yesterday 11:15:00 | Safety Stop | Surface Ponding Limit Reached (82%) | 2 mins 10s | ~7.5 Liters | Cutoff Safe

#### Arduino Serial Telemetry Stream

Live formatted 115200 baud serial packets matching tests 01 to 06 and main controller.

Clear Pause Stream

[SYSTEM] WBACFSPWI Test Integration Serial Console Initialized...

[SYSTEM] Baud Rate: 115200 | Flow Control: None | Status: Connected

###### System Audit Log

Timestamp | Category | Action / Event | Actor / Source
--:--:-- | SYSTEM | Integration Test environment loaded successfully | Browser Client

#### Hardware Pinouts & Wiring Blueprint

Complete reference for all verified modules from tests 01 through 06.

###### Arduino Uno Pin Assignments

Pin | Component | Type / Circuit
A0 | Capacitive Soil Moisture v1.2 | Analog Input (Root Zone)
A1 | Surface Water Level Sensor | Analog Input (Surface Ponding)
A2 | 3S 18650 Battery Voltage | Divider: 100kΩ (R1) / 33kΩ (R2)
A3 | 12V Solar Panel Voltage | Divider: 100kΩ (R3) / 20kΩ (R4)
D7 | 5V Relay Module (DC Pump) | Digital Output (Active LOW)
D8 | Sensor Power Gate (PNP/MOSFET) | Anti-corrosion Power Duty Cycle
D13 | Status / Fault LED | Onboard Diagnostics

###### Autonomous Decision Logic Reference

- Pump Trigger Condition: (Soil Moisture < 35%) AND (Surface Water < 80%) AND (Battery > 10.0V)
- Pump Stop Condition: (Soil Moisture >= 65%) OR (Surface Water >= 80%) OR (Battery <= 10.0V)
- Max Runtime Protection: Continuous pump run capped at 180 seconds with mandatory cooldown.
- Solar Charging Profile: vSolar > 12.0V = Active Solar Harvest | vSolar < 2.0V = Night Mode

##### Add Irrigation Schedule

Schedule Name

Start Time

Duration (Minutes)

Active Days

Mon

Tue

Wed

Thu

Fri

Sat

Sun

Cancel Save Schedule
