Glenn-IT/WBACFSPWI-Web-Based-Automatic-Controller-for-Solar-Powered-Water-Irrigation/test_integration/miniature_blueprint.html

Physical Prototype Blueprint

## Miniature Rice Field Irrigation Model

Complete Scale Model Architecture, Wiring Blueprint, & Interactive Flow Simulator

Open Web Test Panel Run Water Flow Simulation

##### Physical Miniature Layout (Interactive Blueprint)

Click components or Run Simulation button

12V Solar Panel 17.4V

12V 15W/30W Mounted on 25° Tilt Stand

Feeds BMS & Pin A3 Divider

Control Box 3S 11.85V

- • Arduino Uno R3 (ATmega328P)
- • 3S 18650 Pack + 3S BMS Board
- • LM2596 Step-down (12V $\rightarrow$ 5.0V Logic)
- • 5V Relay Module (Pin D7 Pump switch)
- • Resistor Dividers (A2 & A3)

Water Tank Pump: OFF

1.0L - 1.5L Acrylic Reservoir

12V Mini Submersible DC Pump

Rice Paddy Bed Soil: 42% | Depth: 25%

Surface Water Ponding Depth [Pin A1]

🌱 Rice Plants (Miniature) Capacitive Probe [A0]

Rich Loam / Clay Soil Bed (~5-7cm Depth)

##### Miniature Dimension & Material Guide

Section | Recommended Material | Approx. Size
Base Board | Plywood or 5mm Acrylic Base | 45 cm × 35 cm
Rice Paddy Box | Clear Acrylic Box (waterproof sealed) | 25 cm × 20 cm × 10 cm
Water Reservoir | Transparent Container with Lid | 15 cm × 12 cm × 15 cm (1–2L)
Solar Mount | 3D Printed or Aluminum 25° Tilt Stand | Matches 15W/30W Panel size
Control Enclosure | Plastic Project Box (Ventilated) | 18 cm × 12 cm × 6 cm
Irrigation Tubing | Food-grade Flexible Silicone Tubing | 6mm Inner Diameter (ID)

##### Component Information

Click on any component in the blueprint above (Solar Panel, Control Box, Water Tank, or Rice Paddy) to see wiring, specifications, and test results.

Ready for physical assembly. All unit tests passed.

##### Miniature Physical Assembly Steps

Step 1: Paddy Bed

Fill the bottom 5–7cm of the acrylic box with loam/clay soil. Insert the Capacitive Sensor (A0) vertically into the root zone. Mount the Surface Sensor (A1) 2cm above the soil to measure ponding depth.

Step 2: Water & Pump

Submerge the mini 12V pump into the water reservoir. Connect the 6mm silicone tubing from pump outlet and route it along the top edge of the rice paddy bed with micro-dripper / spray holes.

Step 3: Power & Arduino

Mount Arduino Uno, 3S 18650 Battery, LM2596 (set to 5.0V), and 5V Relay module in the control box. Connect common GND across all modules.
