Glenn-IT/WBACFSPWI-Web-Based-Automatic-Controller-for-Solar-Powered-Water-Irrigation/docs/issues.md

1. Dashboard 
- remove the Battery Voltage and change it to Battery Level
- Soil Mosture, can you add a this is sample data arduino data is not yet set it will soon appear the real data on the sensor
- Can you Add graph for Soil Mosture, Water level, Battery Percent or Level,
