Glenn-IT/WBACFSPWI-Web-Based-Automatic-Controller-for-Solar-Powered-Water-Irrigation/arduino/wbacfspwi_arduino_controller/wbacfspwi_arduino_controller.ino

/*
 * WBACFSPWI — Full Standalone Arduino Uno Irrigation Controller
 * Web-Based Automatic Controller for Solar-Powered Water Irrigation
 * 
 * Target Application: Miniature Rice Field Automation
 * 
 * Hardware Setup:
 *   - Arduino Uno R3 (ATmega328P)
 *   - Pin A0: Capacitive Soil Moisture Sensor v1.2 (Root Zone)
 *   - Pin A1: JSN-SR04T Waterproof Ultrasonic TRIG Output (10µs pulse, replaces legacy HW-080)
 *   - Pin A2: 3S 18650 / 12V Motorcycle Battery Voltage Divider (100kΩ / 33kΩ)
 *   - Pin A3: 30W Solar Panel Voltage Divider (100kΩ / 20kΩ)
 *   - Pin A4: JSN-SR04T Waterproof Ultrasonic ECHO Input (Time-of-Flight duration)
 *   - Pin D2: GSM SoftwareSerial RX (from SIM900A 5VT / TXD)
 *   - Pin D3: GSM SoftwareSerial TX (direct to SIM900A 5VR onboard level shifter)
 *   - Pin D7: 5V Relay Module (DC Water Pump Switch, Active LOW)
 *   - Pin D8: Soil Moisture Sensor Power Gate (Corrosion Prevention)
 *   - Pin D9: NodeMCU SoftwareSerial RX (from NodeMCU Pin D2 TX)
 *   - Pin D10: NodeMCU SoftwareSerial TX (to NodeMCU Pin D1 RX via 1kΩ / 2kΩ divider)
 *   - Pin D13: Status / Fault Indicator LED
 * 
 * Autonomous Dual-Channel Telemetry & Decision Logic:
 *   - Channel 1 (WiFi Bridge): Streams real-time JSON to NodeMCU ESP8266 -> XAMPP Apache / MySQL dashboard.
 *   - Channel 2 (Cellular GSM): Sends automated SMS alerts directly to Admin's mobile phone:
 *       * Irrigation STARTED (Water level < 45.0%, pump turns ON).
 *       * Irrigation STOPPED (Water level >= 50.0%, pump turns OFF).
 *       * Irrigation RESTARTED (Water level drops < 45.0% again).
 *   - 3-Layer Safety Net:
 *       1. Hysteresis band (45.0% refill / 50.0% target).
 *       2. Anti-splash minimum runtime (5s min pump run).
 *       3. Wave settling window (10s stabilization delay).
 *   - Battery Protection: Low battery lockout (< 10.0V).
 *   - Continuous Runtime Cap: 180s max runtime with mandatory cooldown.
 */

#include <SoftwareSerial.h>

// ============================================================================
// 1. PIN DEFINITIONS & HARDWARE CONSTANTS
// ============================================================================
const int PIN_ROOT_SOIL      = A0;     // Capacitive Root Soil Moisture Sensor
const int PIN_SURFACE_WATER  = A1;     // HW-080 Surface Water Ponding Sensor (Legacy)
const int PIN_TRIG           = A1;     // JSN-SR04T Waterproof Ultrasonic TRIG Output (10µs pulse)
const int PIN_VBATT          = A2;     // Battery Voltage Divider (100k/33k)
const int PIN_VSOLAR         = A3;     // Solar Panel Voltage Divider (100k/20k)
const int PIN_ECHO           = A4;     // JSN-SR04T Waterproof Ultrasonic ECHO Input (Time-of-Flight)

const int PIN_GSM_RX         = 2;      // Arduino RX <- GSM 5VT / TXD
const int PIN_GSM_TX         = 3;      // Arduino TX -> GSM 5VR (direct for SIM900A)
const int PIN_RELAY_PUMP     = 7;      // 5V Relay Control (DC Water Pump)
const int PIN_SENSOR_PWR     = 8;      // Capacitive Sensor Power Gate
const int PIN_ESP_RX         = 9;      // Arduino RX <- NodeMCU TX (D2 / GPIO4)
const int PIN_ESP_TX         = 10;     // Arduino TX -> NodeMCU RX (D1 / GPIO5) via 1k/2k divider
const int PIN_STATUS_LED     = 13;     // Built-in Status LED

const bool RELAY_ACTIVE_LOW  = true;   // Standard 5V relay modules trigger on LOW
const bool USE_SENSOR_PWR    = true;   // Enable power gating to prevent corrosion

// Dedicated SoftwareSerial Ports
SoftwareSerial espSerial(PIN_ESP_RX, PIN_ESP_TX); // WiFi Bridge Link (NodeMCU)
SoftwareSerial gsmSerial(PIN_GSM_RX, PIN_GSM_TX); // Cellular SMS Link (SIM900A)

// Admin Mobile Phone Numbers for Automated SMS Alerts
char ADMIN_PHONE[20]   = "+639158127228"; // Primary Admin
char ADMIN_PHONE_2[20] = "+639242074903"; // Secondary Admin

// ============================================================================
// 2. CALIBRATION & THRESHOLD VALUES (SYNCHRONIZED WITH SYSTEM MEMORY)
// ============================================================================
const float ARDUINO_VREF     = 5.00;

// Voltage Dividers
const float VBATT_RATIO      = 4.0303; // (100k + 33k) / 33k
const float VSOLAR_RATIO     = 6.0000; // (100k + 20k) / 20k

// Capacitive Root Sensor (Air vs Water raw ADC)
const int SOIL_AIR_RAW       = 408;    // 0% moisture in dry air
const int SOIL_WATER_RAW     = 172;    // 100% moisture in water

// JSN-SR04T Waterproof Ultrasonic Sensor Calibration (Centimeters)
// Live Bench Calibrated: Soil Bed=28.0cm (0%), 50% Target=24.0cm, 40% Refill=24.8cm, 100% Full=20.0cm
float sensorClearanceCM       = 20.0;   // Air gap from transducer face to 100% full mark (28.0 - 8.0)
float containerDepthCM        = 8.0;    // Calibrated usable water depth (28.0 - 20.0)
const float SPEED_OF_SOUND_CM_US = 0.0343; // cm per microsecond at ~25°C
const float MIN_BLIND_ZONE_CM     = 20.0;   // Physical dead band limit of JSN-SR04T

// Legacy HW-080 Moisture Sensor (Preserved for Fallback / Verification)
const int HW080_RAW_DRY      = 1020;   // Stage 0: Probe in dry air (0.0% surface water)
const int HW080_RAW_MID      = 663;    // Stage 1: Water at middle of sensor 7-8cm mark (50.0% depth)
const int HW080_RAW_WET      = 568;    // Stage 2: Probe at container maximum depth (100% full ponding)

// Irrigation Decision Thresholds (Surface Water Level Control with 10% Hysteresis)
const float WATER_TARGET_MAX   = 50.0; // Automatically stop pump when surface water level reaches >= 50.0%
const float WATER_REFILL_MIN   = 40.0; // Automatically start pump only when surface water level drops < 40.0% (10% Hysteresis Gap)

// Safety & Battery Protection Thresholds
const float BATT_MIN_LOCKOUT  = 10.00; // Low battery lockout cutoff (10.0V deep discharge protection)
const float BATT_RESUME_VOLTS = 10.50; // Voltage needed to clear lockout and resume operation

// Timing Protections (in milliseconds)
const unsigned long MIN_PUMP_RUN_MS  = 5000UL;   // 5s minimum runtime (prevents momentary splash cutoffs)
// const unsigned long MAX_PUMP_RUN_MS  = 180000UL; // [DISABLED] 3-min runtime cap — manual switch installed for defense presentation
// const unsigned long PUMP_COOLDOWN_MS = 60000UL;  // [DISABLED] 1-min cooldown — manual switch installed for defense presentation
const unsigned long SETTLING_DELAY_MS= 10000UL;  // 10s water settling / stabilization window
const unsigned long SAMPLE_INTERVAL   = 1000UL;   // Read sensors & evaluate logic every 1s
const unsigned long TELEMETRY_PERIOD  = 1000UL;   // Print telemetry & stream JSON every 1s
const unsigned long SMS_COOLDOWN_MS   = 3000UL;   // 3s spacing between back-to-back SMS sends

// ============================================================================
// 3. SYSTEM STATE VARIABLES
// ============================================================================
bool  pumpState          = false;
bool  isSettling         = false;
bool  lowBatteryLockout  = false;
bool  manualOverride     = false;
bool  manualOverrideState= false;
bool  gsmReady           = false;
int   cycleCount         = 0;

unsigned long pumpStartTime     = 0;
unsigned long pumpStopTime      = 0;
unsigned long settlingStartTime = 0;
unsigned long lastSampleTime    = 0;
unsigned long lastTeleTime      = 0;
unsigned long lastSmsTime       = 0;

float currentRootMoisture = 0.0;
float currentSurfaceWater = 0.0;
float currentDistanceCM   = 0.0;
float currentBattVolts    = 0.0;
float currentSolarVolts   = 0.0;

enum IrrigationEventType {
  EVENT_NONE,
  EVENT_STARTED,
  EVENT_STOPPED,
  EVENT_RESTARTED
};
IrrigationEventType lastTriggeredEvent = EVENT_NONE;

// ============================================================================
// 4. GSM CELLULAR HELPER FUNCTIONS
// ============================================================================

// Flush all leftover bytes in SoftwareSerial buffer
void flushGSMSerial() {
  while (gsmSerial.available()) {
    gsmSerial.read();
  }
}

// Wait for a specific text response with timeout
bool waitForGSMResponse(const char* expected, unsigned long timeoutMs) {
  unsigned long start = millis();
  String resp = "";
  while (millis() - start < timeoutMs) {
    while (gsmSerial.available()) {
      char c = (char)gsmSerial.read();
      resp += c;
    }
    if (resp.indexOf(expected) != -1) {
      return true;
    }
    if (resp.indexOf(F("ERROR")) != -1 || resp.indexOf(F("+CMS ERROR")) != -1) {
      return false;
    }
  }
  return false;
}

// Wait specifically for the SMS body prompt '>'
bool waitForGSMPrompt(unsigned long timeoutMs) {
  unsigned long start = millis();
  while (millis() - start < timeoutMs) {
    while (gsmSerial.available()) {
      char c = (char)gsmSerial.read();
      if (c == '>') {
        return true;
      }
    }
  }
  return false;
}

bool sendATCommand(const String& cmd, const char* expected, unsigned long timeoutMs) {
  flushGSMSerial();
  gsmSerial.println(cmd);

  String resp = "";
  unsigned long start = millis();
  while (millis() - start < timeoutMs) {
    while (gsmSerial.available()) {
      resp += (char)gsmSerial.read();
    }
    if (resp.indexOf(expected) != -1) {
      return true;
    }
    if (resp.indexOf(F("ERROR")) != -1 || resp.indexOf(F("+CMS ERROR")) != -1) {
      return false;
    }
  }
  return false;
}

bool initGSM() {
  Serial.println(F("\n--- Initializing GSM Module (SIM900A) ---"));
  gsmSerial.listen();

  const long candidateBauds[] = {9600, 19200, 115200, 38400, 57600};
  const int numBauds = sizeof(candidateBauds) / sizeof(candidateBauds[0]);
  bool synced = false;
  long activeBaud = 9600;

  Serial.println(F("[INFO] Auto-detecting GSM baud rate..."));
  for (int b = 0; b < numBauds; b++) {
    long testBaud = candidateBauds[b];
    Serial.print(F("[INFO] Testing baud: "));
    Serial.println(testBaud);
    gsmSerial.begin(testBaud);
    delay(200);

    for (int i = 0; i < 3; i++) {
      flushGSMSerial();
      gsmSerial.println(F("AT"));

      unsigned long start = millis();
      String resp = "";
      while (millis() - start < 800) {
        while (gsmSerial.available()) {
          resp += (char)gsmSerial.read();
        }
        if (resp.indexOf(F("OK")) != -1) {
          synced = true;
          activeBaud = testBaud;
          break;
        }
      }
      if (synced) break;
      delay(200);
    }
    if (synced) {
      Serial.print(F("[GSM DETECTED] Connected successfully at "));
      Serial.print(activeBaud);
      Serial.println(F(" baud!"));
      break;
    }
  }

  if (!synced) {
    Serial.println(F("[WARNING] GSM Module not responding to AT commands. Continuing with WiFi telemetry only."));
    espSerial.listen();
    return false;
  }

  // Lock to 9600 baud for stable SoftwareSerial operation
  if (activeBaud != 9600) {
    Serial.println(F("[INFO] Locking GSM module to 9600 baud (AT+IPR=9600)..."));
    gsmSerial.println(F("AT+IPR=9600"));
    delay(400);
    gsmSerial.begin(9600);
    delay(400);
    sendATCommand("AT&W", "OK", 1000);
  }

  sendATCommand("ATE0", "OK", 1000);              // Echo OFF
  sendATCommand("AT+CMEE=2", "OK", 1000);         // Enable verbose error messages
  sendATCommand("AT+CPIN?", "READY", 3000);       // Check SIM status
  sendATCommand("AT+CMGF=1", "OK", 1000);         // Set SMS to Text Mode
  sendATCommand("AT+CSCS=\"GSM\"", "OK", 1000);   // Set GSM character set
  sendATCommand("AT+CSMP=17,167,0,0", "OK", 1000);// Standard SMS-SUBMIT parameters (validity 24h, text mode)

  // Check signal quality
  Serial.println(F("[INFO] Checking signal quality (AT+CSQ)..."));
  flushGSMSerial();
  gsmSerial.println(F("AT+CSQ"));
  unsigned long csqStart = millis();
  String csqResp = "";
  while (millis() - csqStart < 1500) {
    while (gsmSerial.available()) csqResp += (char)gsmSerial.read();
  }
  Serial.print(F("  Signal response: "));
  Serial.println(csqResp);

  // Check network registration (loop up to 10s if searching)
  Serial.println(F("[INFO] Checking network registration (AT+CREG?)..."));
  bool registered = false;
  for (int attempt = 1; attempt <= 5; attempt++) {
    flushGSMSerial();
    gsmSerial.println(F("AT+CREG?"));
    unsigned long regStart = millis();
    String regResp = "";
    while (millis() - regStart < 2000) {
      while (gsmSerial.available()) regResp += (char)gsmSerial.read();
    }
    Serial.print(F("  CREG response: "));
    Serial.println(regResp);

    if (regResp.indexOf(F("0,1")) != -1 || regResp.indexOf(F("0,5")) != -1 ||
        regResp.indexOf(F(",1")) != -1 || regResp.indexOf(F(",5")) != -1) {
      registered = true;
      Serial.println(F("  [SUCCESS] SIM registered on cellular carrier network!"));
      break;
    } else if (regResp.indexOf(F("0,2")) != -1) {
      Serial.println(F("  [INFO] Modem searching for operator network... waiting 2s."));
      delay(2000);
    } else {
      delay(1500);
    }
  }

  if (!registered) {
    Serial.println(F("  [WARNING] SIM not yet registered on network. SMS dispatch may fail until registered."));
  }

  Serial.println(F("--- GSM Module Ready & Configured ---\n"));
  espSerial.listen(); // Return listening focus to NodeMCU WiFi bridge
  return true;
}

bool sendSMS(const char* phoneNumber, const String& message) {
  if (!phoneNumber || strlen(phoneNumber) < 7) {
    Serial.println(F("[ERROR] Invalid recipient phone number."));
    return false;
  }

  if (millis() - lastSmsTime < SMS_COOLDOWN_MS && lastSmsTime != 0) {
    Serial.println(F("[GSM RATE LIMIT] Skipping SMS to protect against carrier throttling."));
    return false;
  }

  Serial.println(F("\n=================================================="));
  Serial.print(F("[SMS DISPATCH] Recipient: "));
  Serial.println(phoneNumber);
  Serial.print(F("[SMS CONTENT]  "));
  Serial.println(message);
  Serial.println(F("=================================================="));

  gsmSerial.listen(); // Switch listening focus to GSM

  // Status LED alert blink
  for (int i = 0; i < 3; i++) {
    digitalWrite(PIN_STATUS_LED, HIGH);
    delay(80);
    digitalWrite(PIN_STATUS_LED, LOW);
    delay(80);
  }

  // Step 1: Clean buffer
  flushGSMSerial();

  // Step 2: Ensure Text Mode (AT+CMGF=1)
  gsmSerial.println(F("AT+CMGF=1"));
  if (!waitForGSMResponse("OK", 2000)) {
    Serial.println(F("[ERROR] Failed to set SMS text mode (AT+CMGF=1)."));
    espSerial.listen();
    return false;
  }

  // Step 3: Ensure SMS-SUBMIT parameters (AT+CSMP=17,167,0,0)
  gsmSerial.println(F("AT+CSMP=17,167,0,0"));
  waitForGSMResponse("OK", 1000);

  // Step 4: Initiate SMS sending with recipient phone number
  flushGSMSerial();
  gsmSerial.print(F("AT+CMGS=\""));
  gsmSerial.print(phoneNumber);
  gsmSerial.println(F("\""));

  // Step 5: Wait for '>' prompt from GSM modem
  if (!waitForGSMPrompt(5000)) {
    Serial.println(F("[ERROR] GSM modem did not return '>' prompt. Canceling..."));
    gsmSerial.write(27); // ESC to abort
    delay(300);
    flushGSMSerial();
    espSerial.listen();
    return false;
  }

  // Step 6: Write message body and terminate with Ctrl+Z (ASCII 26)
  gsmSerial.print(message);
  delay(150);
  gsmSerial.write(26); // ASCII 26 (Ctrl+Z)

  // Step 7: Wait for cellular transmission confirmation (+CMGS: <id> or OK)
  String response = "";
  unsigned long start = millis();
  bool success = false;
  while (millis() - start < 25000UL) { // Cellular transmit may take up to 25s
    while (gsmSerial.available()) {
      char c = (char)gsmSerial.read();
      response += c;
      Serial.write(c); // Echo live modem response to Serial Monitor
    }
    if (response.indexOf(F("+CMGS:")) != -1 || response.indexOf(F("\r\nOK")) != -1) {
      success = true;
      break;
    }
    if (response.indexOf(F("ERROR")) != -1 || response.indexOf(F("+CMS ERROR")) != -1) {
      success = false;
      break;
    }
  }

  if (success) {
    Serial.println(F("\n[SMS STATUS] >>> SMS SENT SUCCESSFULLY! <<<"));
    lastSmsTime = millis();
  } else {
    Serial.print(F("\n[SMS STATUS] >>> SMS FAILED TO SEND. Modem Response: "));
    Serial.println(response);

    if (response.indexOf(F("302")) != -1) {
      Serial.println(F("  [DIAGNOSTIC] CMS ERROR 302: Modem not registered on cellular network. Check antenna or SIM."));
    } else if (response.indexOf(F("304")) != -1 || response.indexOf(F("500")) != -1) {
      Serial.println(F("  [DIAGNOSTIC] CMS ERROR 304/500: SMSC center address missing, invalid CSMP, or SIM out of load/credits."));
    } else if (response.indexOf(F("330")) != -1) {
      Serial.println(F("  [DIAGNOSTIC] CMS ERROR 330: SMSC address error. Check SIM carrier settings."));
    } else if (response.indexOf(F("512")) != -1) {
      Serial.println(F("  [DIAGNOSTIC] CMS ERROR 512: Modem busy. Wait a few seconds before retrying."));
    } else if (response.length() == 0) {
      Serial.println(F("  [DIAGNOSTIC] No response received: Likely GSM power brownout during RF transmission. Ensure 2A power supply + 1000µF capacitor."));
    }
  }

  espSerial.listen(); // Return listening focus to NodeMCU WiFi bridge
  return success;
}

// Broadcast alert SMS to all configured admin recipients
void dispatchAlertSMS(const String& message) {
  if (!gsmReady) return;
  sendSMS(ADMIN_PHONE, message);
  if (strlen(ADMIN_PHONE_2) > 0) {
    delay(1500); // 1.5-second pause for GSM modem transmission recovery
    lastSmsTime = 0; // Clear cooldown so secondary recipient receives alert immediately
    sendSMS(ADMIN_PHONE_2, message);
  }
}

// ============================================================================
// 5. PUMP CONTROL & HARDWARE SENSORS
// ============================================================================

void setPump(bool enable) {
  if (enable == pumpState) return;

  if (enable) {
    // =============================================================
    // PUMP START SEQUENCE: SMS FIRST (WHILE PUMP IS OFF), THEN ENGAGE RELAY
    // =============================================================
    cycleCount++;
    lastTriggeredEvent = (cycleCount > 1) ? EVENT_RESTARTED : EVENT_STARTED;

    String msg = F("WBACFSPWI Alert:\nIrrigation ");
    msg += (cycleCount > 1) ? F("RESTARTED (Cycle #") : F("STARTED.");
    if (cycleCount > 1) { msg += cycleCount; msg += F(")."); }
    msg += F("\nMotor starting now.");
    msg += F("\nWater level: ");
    msg += String(currentSurfaceWater, 1);
    msg += F("% (< 40%).\nSoil moisture: ");
    msg += String(currentRootMoisture, 1);
    msg += F("%");

    if (gsmReady) {
      Serial.println(F("[POWER & SAFETY] Sending 'STARTED' SMS first while pump is OFF (100% clean power & zero overflow delay)..."));
      lastSmsTime = 0; // Clear cooldown so event alert is dispatched immediately
      dispatchAlertSMS(msg);
    }

    // Engage pump relay immediately after SMS is dispatched
    digitalWrite(PIN_RELAY_PUMP, RELAY_ACTIVE_LOW ? LOW : HIGH);
    digitalWrite(PIN_STATUS_LED, HIGH);
    pumpState = true;
    pumpStartTime = millis();
    Serial.println(F("[ACTUATOR] Relay ENGAGED -> 12V DC Water Pump ON! Entering active sensor monitoring loop."));

  } else {
    // =============================================================
    // PUMP STOP SEQUENCE: CUT RELAY IMMEDIATELY FIRST, THEN SEND SMS
    // =============================================================
    // 1. Cut pump power immediately (0ms delay prevents container overflow!)
    digitalWrite(PIN_RELAY_PUMP, RELAY_ACTIVE_LOW ? HIGH : LOW);
    digitalWrite(PIN_STATUS_LED, LOW);
    pumpState = false;
    pumpStopTime = millis();
    Serial.println(F("[ACTUATOR] Relay RELEASED -> 12V DC Water Pump STOPPED immediately (Zero overflow delay)."));

    lastTriggeredEvent = EVENT_STOPPED;

    String msg = F("WBACFSPWI Alert:\nIrrigation STOPPED.");
    msg += F("\nMotor is now OFF.");
    msg += F("\nWater level: ");
    msg += String(currentSurfaceWater, 1);
    msg += F("%\nSoil moisture: ");
    msg += String(currentRootMoisture, 1);
    msg += F("%\nBattery: ");
    msg += String(currentBattVolts, 2);
    msg += F("V");

    if (gsmReady) {
      // 2. Allow 1.0s for inductive kickback & power rail bounce-back
      delay(1000);
      Serial.println(F("[POWER & SAFETY] Sending 'STOPPED' SMS on resting power..."));
      lastSmsTime = 0; // Clear cooldown so event alert is dispatched immediately
      dispatchAlertSMS(msg);
    }
  }
}

float readRootMoisture() {
  if (USE_SENSOR_PWR && PIN_SENSOR_PWR >= 0) {
    digitalWrite(PIN_SENSOR_PWR, HIGH);
    delay(80); // Stabilization
  }

  long sum = 0;
  for (int i = 0; i < 16; i++) {
    sum += analogRead(PIN_ROOT_SOIL);
    delay(2);
  }

  if (USE_SENSOR_PWR && PIN_SENSOR_PWR >= 0) {
    digitalWrite(PIN_SENSOR_PWR, LOW);
  }

  int raw = sum / 16;
  float pct = 100.0 * (float)(SOIL_AIR_RAW - raw) / (float)(SOIL_AIR_RAW - SOIL_WATER_RAW);
  return constrain(pct, 0.0, 100.0);
}

// Single acoustic pulse-echo time-of-flight measurement via JSN-SR04T
float singlePingCM() {
  digitalWrite(PIN_TRIG, LOW);
  delayMicroseconds(4);

  digitalWrite(PIN_TRIG, HIGH);
  delayMicroseconds(10);
  digitalWrite(PIN_TRIG, LOW);

  unsigned long duration = pulseIn(PIN_ECHO, HIGH, 35000UL); // 35ms timeout (~6m)
  if (duration == 0) return -1.0;

  return (float)duration * SPEED_OF_SOUND_CM_US / 2.0;
}

// Multi-sample median filtered distance reading to reject surface ripples & acoustic jitter
float readFilteredDistanceCM(int samples = 5) {
  float readings[10];
  if (samples > 10) samples = 10;
  if (samples < 1)  samples = 1;

  int validCount = 0;
  for (int i = 0; i < samples; i++) {
    float d = singlePingCM();
    if (d > 0.0) {
      readings[validCount++] = d;
    }
    delay(20);
  }

  if (validCount == 0) return -1.0;

  // Simple sorting for median extraction
  for (int i = 0; i < validCount - 1; i++) {
    for (int j = i + 1; j < validCount; j++) {
      if (readings[i] > readings[j]) {
        float temp = readings[i];
        readings[i] = readings[j];
        readings[j] = temp;
      }
    }
  }
  return readings[validCount / 2];
}

// JSN-SR04T Non-Contact Surface Water Depth Percentage (0.0% to 100.0%)
float readSurfaceWater() {
  float dist = readFilteredDistanceCM(5);
  if (dist > 0.0) {
    currentDistanceCM = dist;
    float emptyFloorDistance = sensorClearanceCM + containerDepthCM;
    float depth = emptyFloorDistance - dist;
    float pct = (depth / containerDepthCM) * 100.0;
    return constrain(pct, 0.0, 100.0);
  }
  // Return last known reading if acoustic echo timed out
  return currentSurfaceWater;
}

float readBatteryVoltage() {
  long sum = 0;
  for (int i = 0; i < 16; i++) {
    sum += analogRead(PIN_VBATT);
    delay(2);
  }
  float avgAdc = (float)sum / 16.0;
  return (avgAdc / 1023.0) * ARDUINO_VREF * VBATT_RATIO;
}

float readSolarVoltage() {
  long sum = 0;
  for (int i = 0; i < 16; i++) {
    sum += analogRead(PIN_VSOLAR);
    delay(2);
  }
  float avgAdc = (float)sum / 16.0;
  return (avgAdc / 1023.0) * ARDUINO_VREF * VSOLAR_RATIO;
}

void printTelemetry() {
  Serial.println(F("--------------------------------------------------"));
  Serial.print(F("Time: ")); Serial.print(millis() / 1000); Serial.println(F("s"));
  
  Serial.print(F("Root Moisture   : ")); Serial.print(currentRootMoisture, 1); Serial.println(F(" %"));
  Serial.print(F("Surface Water   : ")); Serial.print(currentSurfaceWater, 1); Serial.print(F(" %"));
  if (currentDistanceCM > 0.0) {
    Serial.print(F(" [Dist: ")); Serial.print(currentDistanceCM, 1); Serial.print(F("cm]"));
  }
  Serial.println();
  Serial.print(F("Battery Voltage : ")); Serial.print(currentBattVolts, 2); Serial.print(F(" V "));
  if (lowBatteryLockout) Serial.print(F("[LOW BATT LOCK]"));
  Serial.println();
  
  Serial.print(F("Solar Output    : ")); Serial.print(currentSolarVolts, 2); Serial.println(F(" V"));
  Serial.print(F("Pump Relay State: ")); 
  if (pumpState) {
    Serial.println(F("ON (Irrigating)"));
  } else if (isSettling) {
    Serial.println(F("OFF (10s Settling Verification)"));
  } else {
    Serial.println(F("OFF (Standby)"));
  }
  
  // [DISABLED] Timeout cooldown alert removed — manual switch installed for defense presentation
  Serial.println(F("--------------------------------------------------"));

  // Send formatted JSON line over SoftwareSerial to NodeMCU ESP8266 WiFi Bridge
  espSerial.print(F("{\"soil_moisture\":"));
  espSerial.print(currentRootMoisture, 1);
  espSerial.print(F(",\"water_level\":"));
  espSerial.print(currentSurfaceWater, 1);
  espSerial.print(F(",\"battery_voltage\":"));
  espSerial.print(currentBattVolts, 2);
  espSerial.print(F(",\"solar_output\":"));
  espSerial.print(currentSolarVolts, 2);
  espSerial.print(F(",\"pump_state\":\""));
  espSerial.print(pumpState ? F("on") : F("off"));
  espSerial.println(F("\"}"));
}

// ============================================================================
// 6. SETUP & MAIN LOOP
// ============================================================================

void setup() {
  Serial.begin(115200);
  // Non-blocking wait for Serial: allow up to 2 seconds if USB is connected, otherwise continue standalone immediately
  while (!Serial && millis() < 2000) { delay(10); }

  // 1. Initialize relay pin to safe OFF (HIGH for Active LOW) BEFORE pinMode
  digitalWrite(PIN_RELAY_PUMP, RELAY_ACTIVE_LOW ? HIGH : LOW);
  pinMode(PIN_RELAY_PUMP, OUTPUT);
  digitalWrite(PIN_RELAY_PUMP, RELAY_ACTIVE_LOW ? HIGH : LOW);

  pinMode(PIN_STATUS_LED, OUTPUT);
  digitalWrite(PIN_STATUS_LED, LOW);

  // Initialize JSN-SR04T Waterproof Ultrasonic Pins
  pinMode(PIN_TRIG, OUTPUT);
  pinMode(PIN_ECHO, INPUT);
  digitalWrite(PIN_TRIG, LOW);

  if (USE_SENSOR_PWR && PIN_SENSOR_PWR >= 0) {
    pinMode(PIN_SENSOR_PWR, OUTPUT);
    digitalWrite(PIN_SENSOR_PWR, LOW);
  }

  // 2. Initialize SoftwareSerial for NodeMCU WiFi Bridge & GSM Module
  espSerial.begin(9600);
  espSerial.listen();

  Serial.println(F("=================================================="));
  Serial.println(F(" WBACFSPWI: Solar Rice Irrigation Controller     "));
  Serial.println(F(" Standalone Arduino Uno Automation Firmware      "));
  Serial.println(F(" Dual Telemetry: NodeMCU WiFi Bridge & SIM900A GSM"));
  Serial.println(F("3-Layer Automatic Surface Water Level Control:"));
  Serial.println(F("  - TARGET MAX (PUMP OFF) : >= 50.0% Surface Water"));
  Serial.println(F("  - REFILL MIN (PUMP ON)  : < 40.0% Surface Water (10% Hysteresis Gap)"));
  Serial.println(F("  - MINIMUM RUNTIME       : 5 Seconds Anti-Splash Protection"));
  Serial.println(F("  - SETTLING WINDOW       : 10 Seconds Wave Stabilization"));
  Serial.println(F("=================================================="));

  // =============================================================
  // STEP 1: 5-SECOND GSM BASEBAND WARM-UP COUNTDOWN
  // =============================================================
  // Gives the SIM900A module time to power on its internal CPU & radio after power is applied
  Serial.println(F("\n[STARTUP] Step 1/3: 5-Second GSM Baseband Boot-Up Countdown..."));
  Serial.println(F("  Allowing SIM900A module to complete hardware power-on & boot baseband..."));
  for (int s = 5; s > 0; s--) {
    Serial.print(F("  -> GSM boot countdown: "));
    Serial.print(s);
    Serial.println(F("s"));
    digitalWrite(PIN_STATUS_LED, (s % 2 == 0) ? HIGH : LOW);
    delay(1000);
  }
  digitalWrite(PIN_STATUS_LED, LOW);

  // =============================================================
  // STEP 2: INITIALIZE & CHECK GSM MODULE, SIGNAL & REGISTRATION
  // =============================================================
  Serial.println(F("\n[STARTUP] Step 2/3: Checking GSM Module, Signal & Network Registration..."));
  gsmReady = initGSM();
  if (gsmReady) {
    Serial.println(F("[SYSTEM] GSM SMS Alert Module: ACTIVE"));
    Serial.print(F("  • Primary Admin   : ")); Serial.println(ADMIN_PHONE);
    Serial.print(F("  • Secondary Admin : ")); Serial.println(ADMIN_PHONE_2);
  } else {
    Serial.println(F("[SYSTEM] GSM SMS Alert Module: OFFLINE (Operating with WiFi Bridge)"));
  }

  // =============================================================
  // STEP 3: 3-SECOND SENSOR STABILIZATION COUNTDOWN
  // =============================================================
  // Takes baseline ultrasonic & soil readings before starting autonomous maintenance
  Serial.println(F("\n[STARTUP] Step 3/3: 3-Second Sensor Stabilization Countdown..."));
  Serial.println(F("  Locking ultrasonic baseline & stabilizing sensor inputs..."));
  for (int s = 3; s > 0; s--) {
    Serial.print(F("  -> Sensor stabilization countdown: "));
    Serial.print(s);
    Serial.println(F("s"));

    // Warm-up sensor readings
    currentRootMoisture = readRootMoisture();
    currentSurfaceWater = readSurfaceWater();
    currentBattVolts    = readBatteryVoltage();
    currentSolarVolts   = readSolarVoltage();

    digitalWrite(PIN_STATUS_LED, HIGH);
    delay(500);
    digitalWrite(PIN_STATUS_LED, LOW);
    delay(500);
  }
  digitalWrite(PIN_STATUS_LED, LOW);
  Serial.println(F("[STARTUP] Setup complete! Starting autonomous irrigation maintenance...\n"));
}

void loop() {
  unsigned long now = millis();

  // -------------------------------------------------------------
  // A. Periodic Sensor Sampling & Automation Logic (Every 1s)
  // -------------------------------------------------------------
  if (now - lastSampleTime >= SAMPLE_INTERVAL || lastSampleTime == 0) {
    lastSampleTime = now;

    currentRootMoisture = readRootMoisture();
    currentSurfaceWater = readSurfaceWater();
    currentBattVolts    = readBatteryVoltage();
    currentSolarVolts   = readSolarVoltage();

    // 1. Battery Protection Check
    if (currentBattVolts < BATT_MIN_LOCKOUT) {
      lowBatteryLockout = true;
    } else if (lowBatteryLockout && currentBattVolts >= BATT_RESUME_VOLTS) {
      lowBatteryLockout = false;
    }

    // 2. Pump Timeout & Cooldown Check — [DISABLED] Manual switch installed for defense presentation

    // 3. Automated Decision Logic with 10s Settling Safety Net & Manual Override
    if (lowBatteryLockout) {
      setPump(false);
      isSettling = false;
    } else if (manualOverride) {
      setPump(manualOverrideState);
      isSettling = false;
    } else if (isSettling) {
      if (now - settlingStartTime >= SETTLING_DELAY_MS) {
        isSettling = false;
        if (currentSurfaceWater < WATER_REFILL_MIN) {
          Serial.println(F(">>> [REFILL] 10s Settling complete! Level settled < 40.0% -> Resuming pump"));
          setPump(true);
        } else {
          Serial.println(F(">>> [STABLE] 10s Settling complete! Level settled >= 40.0% -> Pump stays OFF"));
        }
      }
    } else if (pumpState) {
      // Layer 2: Minimum Run Time Check (Enforce at least 5s before allowing target shutoff)
      if (now - pumpStartTime >= MIN_PUMP_RUN_MS) {
        // Layer 1: Target Reached Check
        if (currentSurfaceWater >= WATER_TARGET_MAX) {
          setPump(false);
          isSettling = true;
          settlingStartTime = now;
          Serial.println(F(">>> [TARGET REACHED] Starting 10s settling verification..."));
        }
      }
    } else {
      // Pump is idle and not settling: start pump if below threshold (< 40.0%)
      if (currentSurfaceWater < WATER_REFILL_MIN) {
        setPump(true);
      }
    }
  }

  // -------------------------------------------------------------
  // B. Telemetry Output & WiFi Stream (Every 1s)
  // -------------------------------------------------------------
  if (now - lastTeleTime >= TELEMETRY_PERIOD || lastTeleTime == 0) {
    lastTeleTime = now;
    printTelemetry();
  }

  // -------------------------------------------------------------
  // C. Status LED Indicator Handling
  // -------------------------------------------------------------
  if (lowBatteryLockout) {
    digitalWrite(PIN_STATUS_LED, (now / 200) % 2 == 0 ? HIGH : LOW);
  } else if (pumpState) {
    digitalWrite(PIN_STATUS_LED, HIGH);
  } else {
    digitalWrite(PIN_STATUS_LED, (now / 1500) % 2 == 0 ? HIGH : LOW);
  }

  // -------------------------------------------------------------
  // D. Process Remote WiFi Commands from NodeMCU ESP8266
  // -------------------------------------------------------------
  if (espSerial.available() > 0) {
    String cmd = espSerial.readStringUntil('\n');
    cmd.trim();
    if (cmd == "PUMP_ON") {
      manualOverride = true;
      manualOverrideState = true;
      setPump(true);
      Serial.println(F(">>> [REMOTE COMMAND via WiFi] Manual Override: PUMP ON"));
    } else if (cmd == "PUMP_OFF") {
      manualOverride = true;
      manualOverrideState = false;
      setPump(false);
      Serial.println(F(">>> [REMOTE COMMAND via WiFi] Manual Override: PUMP OFF"));
    } else if (cmd == "PUMP_AUTO") {
      if (manualOverride) {
        manualOverride = false;
        if (pumpState && currentSurfaceWater >= WATER_REFILL_MIN) {
          setPump(false);
        }
        Serial.println(F(">>> [REMOTE COMMAND via WiFi] Manual Override Cleared -> AUTO Mode Resumed"));
      }
    }
  }

  delay(20);
}
