Glenn-IT/WBACFSPWI-Web-Based-Automatic-Controller-for-Solar-Powered-Water-Irrigation/arduino/07_dual_sensor_pump_integration_test/07_dual_sensor_pump_integration_test.ino

  /*
  * WBACFSPWI — Test 07: Dual Sensor (Capacitive + HW-080) & Relay Pump Integration Test
  * 
  * Hardware Setup:
  *   - Arduino Uno R3
  *   - Pin A0: Capacitive Soil Moisture Sensor v1.2 (Root Zone Soil Moisture)
  *   - Pin D8: Capacitive Sensor Power Gate (VCC control to prevent corrosion)
  *   - Pin A1: HW-080 Sensor (Surface Standing Water / Ponding Depth)
  *   - Pin D7: 5V Relay Module (Switches 12V DC Water Pump)
  *   - Pin D13: Status / Heartbeat LED
  * 
  * Decision Logic (Rice Field Rules):
  *   1. PUMP TURNS ON if:
  *        - Root Soil Moisture < 50.0% (Soil needs irrigation)
  *        - AND Surface Water Level < 70.0% (Safe standing depth, not flooded)
  *   2. PUMP TURNS OFF if:
  *        - Surface Water Level >= 70.0% (Ponding safety cap reached -> FLOOD CUTOFF)
  *        - OR Root Soil Moisture >= 70.0% (Target root moisture satisfied)
  *        - OR Continuous runtime reaches MAX_PUMP_RUNTIME_SEC (180s safety cap)
  * 
  * Calibrated ADC Values (from Physical Tests):
  *   - Capacitive Soil Sensor:  SOIL_AIR_RAW = 417 (0%),   SOIL_WATER_RAW = 153 (100%)
  *   - HW-080 Surface Sensor:   HW080_RAW_DRY = 1019 (0%), HW080_RAW_WET = 508 (100%)
  */

  // ============================================================================
  // 1. PIN DEFINITIONS
  // ============================================================================
  const int PIN_ROOT_SOIL      = A0;  // Capacitive Analog Out
  const int PIN_SENSOR_PWR     = 8;   // Capacitive VCC Power Gate
  const int PIN_SURFACE_WATER  = A1;  // HW-080 Analog Out
  const int PIN_RELAY_PUMP     = 7;   // 5V Relay IN (Active LOW)
  const int PIN_STATUS_LED     = 13;  // Built-in LED

  const bool RELAY_ACTIVE_LOW  = true;

  // ============================================================================
  // 2. CALIBRATION CONSTANTS
  // ============================================================================
  const int SOIL_AIR_RAW       = 408;   // 0% root moisture in dry air
  const int SOIL_WATER_RAW     = 172;   // 100% root moisture submerged in water

  // Calibrated HW-080 constants (Calibrated to Physical Ruler & Water Height):
  const int HW080_RAW_DRY      = 1020;  // 0.0% surface standing water (dry surface)
  const int HW080_RAW_MID      = 663;   // 50.0% water at middle of sensor (7-8cm mark)
  const int HW080_RAW_WET      = 568;   // 100.0% full container depth (top header / max flood)

  // ============================================================================
  // 3. IRRIGATION CONTROL THRESHOLDS (3-LAYER SAFETY: HYSTERESIS + MIN RUN + SETTLING)
  // ============================================================================
  const float WATER_TARGET_MAX   = 50.0; // Turn pump OFF when water level reaches >= 50.0%
  const float WATER_REFILL_MIN   = 40.0; // Turn pump ON whenever water level drops < 40.0% (10% Hysteresis Gap)

  const unsigned long MIN_PUMP_RUN_MS     = 5000UL;   // 5 seconds minimum runtime (prevents momentary splash cutoffs)
  const unsigned long MAX_PUMP_RUNTIME_MS = 180000UL; // 180 seconds continuous run protection
  const unsigned long SETTLING_DELAY_MS   = 10000UL;  // 10 seconds water stabilization / settling window

  // ============================================================================
  // 4. SYSTEM STATE VARIABLES
  // ============================================================================
  bool pumpState = false;
  bool isSettling = false;
  unsigned long pumpStartTime = 0;
  unsigned long pumpStopTime = 0;
  unsigned long settlingStartTime = 0;
  unsigned long lastLoopTime = 0;
  int lastRawHW080 = 0;

  void setPump(bool enable, const char* reason) {
    // Always enforce physical GPIO pin state
    digitalWrite(PIN_RELAY_PUMP, enable ? (RELAY_ACTIVE_LOW ? LOW : HIGH) : (RELAY_ACTIVE_LOW ? HIGH : LOW));
    digitalWrite(PIN_STATUS_LED, enable ? HIGH : LOW);

    if (enable != pumpState) {
      pumpState = enable;
      if (pumpState) {
        pumpStartTime = millis();
        Serial.print(F(">>> [ACTION] PUMP STARTED | Reason: "));
        Serial.println(reason);
      } else {
        pumpStopTime = millis();
        Serial.print(F(">>> [ACTION] PUMP STOPPED | Reason: "));
        Serial.println(reason);
      }
    }
  }

  // Read Capacitive Soil Moisture (Data Telemetry Only)
  float readRootSoilMoisture() {
    digitalWrite(PIN_SENSOR_PWR, HIGH);
    delay(50); // Sensor stabilization

    long sum = 0;
    for (int i = 0; i < 16; i++) {
      sum += analogRead(PIN_ROOT_SOIL);
      delay(5);
    }
    digitalWrite(PIN_SENSOR_PWR, LOW);

    int raw = (int)(sum / 16);
    float pct = 100.0 * (float)(SOIL_AIR_RAW - raw) / (float)(SOIL_AIR_RAW - SOIL_WATER_RAW);
    return constrain(pct, 0.0, 100.0);
  }

  // Read HW-080 Surface Water Level (Primary Controller with Physical Ruler 3-Point Calibration)
  float readSurfaceWaterLevel() {
    long sum = 0;
    for (int i = 0; i < 16; i++) {
      sum += analogRead(PIN_SURFACE_WATER);
      delay(5);
    }
    lastRawHW080 = (int)(sum / 16);

    if (lastRawHW080 >= HW080_RAW_DRY) {
      return 0.0;
    } else if (lastRawHW080 >= HW080_RAW_MID) {
      float pct = 50.0 * (float)(HW080_RAW_DRY - lastRawHW080) / (float)(HW080_RAW_DRY - HW080_RAW_MID);
      return constrain(pct, 0.0, 50.0);
    } else {
      float pct = 50.0 + 50.0 * (float)(HW080_RAW_MID - lastRawHW080) / (float)(HW080_RAW_MID - HW080_RAW_WET);
      return constrain(pct, 0.0, 100.0);
    }
  }

  void setup() {
    Serial.begin(115200);
    while (!Serial) { delay(10); }

    pinMode(PIN_SENSOR_PWR, OUTPUT);
    digitalWrite(PIN_SENSOR_PWR, LOW);

    pinMode(PIN_RELAY_PUMP, OUTPUT);
    digitalWrite(PIN_RELAY_PUMP, RELAY_ACTIVE_LOW ? HIGH : LOW); // Ensure Pump is OFF initially

    pinMode(PIN_STATUS_LED, OUTPUT);
    digitalWrite(PIN_STATUS_LED, LOW);

    Serial.println(F("=================================================================="));
    Serial.println(F(" WBACFSPWI: Dual Sensor & Relay Pump Integrated Controller Test  "));
    Serial.println(F("=================================================================="));
    Serial.println(F("3-Layer Automatic Surface Water Level Maintenance:"));
    Serial.println(F("  - TARGET MAX (PUMP OFF) : >= 50.0% Surface Water"));
    Serial.println(F("  - REFILL MIN (PUMP ON)  : < 40.0% Surface Water (10% Hysteresis Gap)"));
    Serial.println(F("  - MINIMUM RUNTIME       : 5 Seconds (Anti-Splash Protection)"));
    Serial.println(F("  - SETTLING WINDOW       : 10 Seconds Wave Stabilization"));
    Serial.println(F("  - Calibrated            : HW080 Dry=1020, Mid=663, Full=568"));
    Serial.println(F("=================================================================="));
    
    // 30-Second Sensor Calibration & Stabilization Window
    Serial.println(F("[STARTUP] 30-Second Sensor Calibration & Stabilization Window..."));
    for (int sec = 30; sec > 0; sec--) {
      Serial.print(F("  -> Stabilizing sensors... "));
      Serial.print(sec);
      Serial.println(F("s remaining"));
      readRootSoilMoisture();
      readSurfaceWaterLevel();
      delay(1000);
    }
    Serial.println(F("[STARTUP] Calibration window complete! Starting autonomous maintenance...\n"));
  }

  void loop() {
    float rootMoisture = readRootSoilMoisture();
    float surfaceWater = readSurfaceWaterLevel();
    unsigned long now = millis();

    // Safety: Continuous Runtime Limit check
    if (pumpState && (now - pumpStartTime >= MAX_PUMP_RUNTIME_MS)) {
      setPump(false, "Continuous 180s Safety Runtime Cap Hit");
      isSettling = false;
    }

    // ==========================================================================
    // Automated Decision Logic: 3-Layer Protection (Hysteresis + Min Run + Settling)
    // ==========================================================================
    if (isSettling) {
      // Layer 3: Water is settling (10-second stabilization window)
      unsigned long elapsedSettling = now - settlingStartTime;
      if (elapsedSettling >= SETTLING_DELAY_MS) {
        isSettling = false;
        // Re-evaluate with settled surface water (45.0% - 50.0% buffer zone)
        if (surfaceWater < WATER_REFILL_MIN) {
          Serial.println(F(">>> [REFILL] 10s Settling complete! Level settled < 45.0% -> Resuming pump"));
          setPump(true, "Post-settling reading below 45.0%");
        } else {
          Serial.println(F(">>> [STABLE] 10s Settling complete! Level settled >= 45.0% -> Pump stays OFF"));
        }
      }
    } else if (pumpState) {
      // Layer 2: Minimum Run Time Check (Enforce at least 5s before allowing target shutoff)
      if (now - pumpStartTime >= MIN_PUMP_RUN_MS) {
        // Layer 1: Target Reached Check
        if (surfaceWater >= WATER_TARGET_MAX) {
          setPump(false, "Surface Reached Target (>= 50.0%) -> Starting 10s Settling Check");
          isSettling = true;
          settlingStartTime = now;
        }
      }
    } else {
      // Pump is idle and not settling: Start pump when below 45% hysteresis refill line
      if (surfaceWater < WATER_REFILL_MIN) {
        setPump(true, "Surface Water Below Refill Level (< 45.0%) -> Pumping to 50.0%");
      }
    }

    // Print Formatted Telemetry Line with Raw ADC
    Serial.print(F("[LIVE TELEMETRY] Root Moisture: "));
    Serial.print(rootMoisture, 1);
    Serial.print(F("% | Surface Water: "));
    Serial.print(surfaceWater, 1);
    Serial.print(F("% (Raw ADC: "));
    Serial.print(lastRawHW080);
    Serial.print(F(") | Pump Relay: "));

    if (pumpState) {
      unsigned long runSec = (now - pumpStartTime) / 1000;
      Serial.print(F("RUNNING (ON for "));
      Serial.print(runSec);
      Serial.print(F("s)"));
    } else if (isSettling) {
      unsigned long remainSec = (SETTLING_DELAY_MS - (now - settlingStartTime)) / 1000 + 1;
      Serial.print(F("SETTLING (OFF - "));
      Serial.print(remainSec);
      Serial.print(F("s remain)"));
    } else {
      Serial.print(F("STANDBY (OFF)"));
    }

    Serial.print(F(" | Status: "));
    if (isSettling) {
      Serial.println(F("SETTLING WATER (Waiting 10s for ripples to settle)"));
    } else if (pumpState) {
      Serial.println(F("PUMPING WATER (Refilling until surface reaches 50.0%)"));
    } else if (surfaceWater >= WATER_TARGET_MAX) {
      Serial.println(F("TARGET MAINTAINED (>= 50.0%) -> STABLE"));
    } else {
      Serial.println(F("BUFFER ZONE (45.0% - 50.0%) -> STANDBY"));
    }

    delay(1000);
  }
