Glenn-IT/WBACFSPWI-Web-Based-Automatic-Controller-for-Solar-Powered-Water-Irrigation/(commit log)

2026-07-06 feat: Implement admin dashboard AJAX endpoint for live data retrieval
    - Added `dashboard-data.php` to provide real-time sensor readings, alerts, and today's schedules for the admin dashboard.
    feat: Create device schedule polling endpoint
    - Introduced `pull-schedule.php` for devices to fetch active schedules and any pending manual overrides.
    feat: Add device reporting endpoint for sensor readings
    - Implemented `report.php` for devices to post sensor readings and pump state, including alert evaluation.
    style: Add CSS styles for the application
    - Created `app.css` to style the application, including sidebar, navigation links, and responsive design.
    feat: Implement JavaScript functionalit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
2026-07-08 fix: replace Go Back button with Logout on Under Construction page
    Same fix cherry-picked into v1.00; applied on main so all future
    versions inherit it.
2026-07-08 feat: add initial SQL dump for WBACFSPWI database with table structures and sample data
2026-07-28 feat: add sample data generation for reports when no real data is available
2026-07-31 docs: add v4.01 to rollout schedule and commit hash table
    v4.01 cherry-picks the Reports "Irrigation Logs" rename + sort filter
    onto the v4.00 tag, skipping unrelated main commits since v4.00.
2026-08-13 feat: add CSV export for sensor readings and enhance user management validations
2026-08-23 Update soil moisture calibration values in sensor code and documentation
2026-08-23 Add troubleshooting and calibration log for system verification and sensor calibration details
2026-08-23 Calibrate HW-080 surface water sensor (1017 air, 260 full wet) and update daily log
2026-08-23 Calibrate HW-080 5-stage water rise from note.md (1019 dry, 508 full) and push
2026-08-23 Create Test 07 integrated dual sensor & pump test and update controller thresholds (50% on, 70% off)
2026-08-23 Update dual-sensor logic: pump only turns off when surface water reaches 70%, disregarding capacitive saturation
2026-08-23 Update Test 07 & controller: pump controlled purely by HW-080 (30% ON, 85% OFF), capacitive is telemetry only
2026-08-23 Update Test 07 & controller: 10s sensor startup stabilization window, constant 85% water level maintenance (refill <80%, stop >=85%)
2026-08-23 Recalibrate HW-080 full depth to 580 ADC and add live Raw ADC to telemetry output
2026-08-31 feat(arduino): add calibration registry and system memory sync rule
2026-08-31 fix(calibration): recalibrate HW-080 surface water sensor (Dry=1020, Full=360)
    [02_surface_water_level_test.ino, 07_dual_sensor_pump_integration_test.ino, wbacfspwi_arduino_controller.ino]
2026-08-31 fix(calibration): implement two-stage piecewise curve for HW-080 surface water sensor
    [02_surface_water_level_test.ino, 07_dual_sensor_pump_integration_test.ino, wbacfspwi_arduino_controller.ino]
2026-08-31 fix(calibration): set HW-080 3-point calibration with middle anchor ADC 410 -> 50.0%
    [02_surface_water_level_test.ino, 07_dual_sensor_pump_integration_test.ino, wbacfspwi_arduino_controller.ino]
2026-08-31 sync(arduino): sync user calibrated constants (Dry=1020, Mid=410, Wet=355) across all sketches
2026-08-31 feat(irrigation): set automatic pump trigger to maintain exact 80.0% surface water level
2026-08-31 fix(relay): change relay active state to false for correct module triggering
    [wbacfspwi_arduino_controller.ino]
2026-08-31 fix(relay): fix GPIO pin startup initialization and enforce continuous physical OFF state
    [07_dual_sensor_pump_integration_test.ino, wbacfspwi_arduino_controller.ino]
2026-09-03 Update RELAY_ACTIVE_LOW setting to true in Arduino controller
2026-09-03 feat(arduino): add Test 08 12V DC power adapter presentation mode test suite and wiring guide
2026-09-03 fix(controller): set RELAY_ACTIVE_LOW to true for standard active-low relay logic
    [wbacfspwi_arduino_controller.ino]
2026-09-09 feat(system): sync ESP8266 WiFi bridge, 12V motorcycle battery profile, and 66-point verification suite
    - Add ESP8266 WiFi bridge (Test 09 and firmware/wbacfspwi_esp8266_node) with bidirectional SoftwareSerial and voltage divider logic shifter
    - Support 12V Motorcycle Lead-Acid/AGM battery profile (10.5V-14.4V) in config/device.php, CALIBRATION_REGISTRY, and schematics
    - Synchronize Master Controller and all 9 test wiring guides with dark SVG breadboards and interactive module filters
    - Create SYSTEM_MEMORY.md, system_synchronization_map.md, and scripts/verify_sync.php (66/66 checks passing)
    - Fix database migration ordering prefix to 003_add_water_level.sql
    [08_dc_adapter_presentation_test.ino, 09_esp8266_wifi_bridge_test.ino, wbacfspwi_arduino_controller.ino, wbacfspwi_esp8266_node.ino]
2026-09-09 fix(firmware): remove unused ArduinoJson include from NodeMCU firmware
    [wbacfspwi_esp8266_node.ino]
2026-09-09 fix(controller): close printTelemetry function brace before setup
    [wbacfspwi_arduino_controller.ino]
2026-09-10 feat(dashboard): display actual battery voltage prominently on dashboard and update resting ceiling
2026-09-10 feat(pump-control): add manual on/off/auto switch to web dashboard and sync firmware
2026-09-12 feat(hardware): add Test 10 GSM module SMS irrigation alert test with interactive wiring guide and sync checks
2026-09-12 feat(hardware): synchronize Test 07/Test 10 wiring guides, Manhattan SVG breadboard, and SIM900A support
2026-09-12 fix(gsm): synchronize direct SIM900A 5VR/5VT wiring and multi-baud auto-detection across entire system
    [10_gsm_sms_irrigation_alert_test.ino]
2026-09-12 fix(dashboard): synchronize awaiting-telemetry state to display clean placeholders (--%) instead of fake sample data
2026-09-12 fix(dashboard): remove manual control switch buttons from dashboard UI in favor of clean autonomous display
2026-09-12 feat(controller): integrate SIM900A GSM SMS alert system into master Arduino Uno controller sketch
2026-09-12 feat(controller): implement 30-second pre-startup calibration and network stabilization window
2026-09-12 fix(control): align 10s post-settling refill trigger to < 45.0% and keep pump shut off when >= 45.0%
    [07_dual_sensor_pump_integration_test.ino, wbacfspwi_arduino_controller.ino]
2026-09-12 fix(calibration): synchronize HW-080 surface water sensor calibration to 1020/663/568 across all sketches and specs
    [02_surface_water_level_test.ino, 07_dual_sensor_pump_integration_test.ino, 08_dc_adapter_presentation_test.ino, 10_gsm_sms_irrigation_alert_test.ino, wbacfspwi_arduino_controller.ino]
2026-09-12 fix(test07): align 10s settling evaluation with 45% refill threshold and 30s startup window
    [07_dual_sensor_pump_integration_test.ino]
2026-09-18 feat(hardware): integrate JSN-SR04T waterproof ultrasonic sensor with live bench calibration
2026-09-19 fix(calibration): calibrate ultrasonic sensor base to 28.0cm with 16.8cm clearance and 11.2cm usable depth
    [11_jsn_sr04t_ultrasonic_water_level_test.ino, wbacfspwi_arduino_controller.ino]
2026-09-19 fix(calibration): calibrate ultrasonic sensor base to 26.0cm with 18.8cm clearance and 7.2cm usable depth
    [11_jsn_sr04t_ultrasonic_water_level_test.ino, wbacfspwi_arduino_controller.ino]
2026-09-19 fix(calibration): calibrate ultrasonic soil bed to 24.4cm (0%) with locked 22.4cm 50% target
    [11_jsn_sr04t_ultrasonic_water_level_test.ino, wbacfspwi_arduino_controller.ino]
2026-09-19 feat(sms): dispatch immediate SMS alerts on motor start, stop, and restart with clear motor status
2026-09-21 Update the 3 minute cut off
2026-09-21 calibration: sync soil sensor readings across all sketches (AIR=408, WATER=172) and disable pump runtime failsafe for defense presentation
    [01_soil_root_capacitive_test.ino, 07_dual_sensor_pump_integration_test.ino, 08_dc_adapter_presentation_test.ino, wbacfspwi_arduino_controller.ino]
2026-09-21 feat(calibration): recalibrate JSN-SR04T ultrasonic geometry for new container (28cm floor, 24cm 50%, 20cm 100%)
2026-09-24 update a circuit solar panel
2026-09-24 Dashboard Pump on off
2026-09-24 feat(dashboard): add manual pump controls with 10s anti-spam loading lock for SIM module protection
2026-09-24 fix(schedule): sync PHP timezone with Manila time, enforce PUMP_OFF on expiration, and auto-disengage pump
    [wbacfspwi_arduino_controller.ino]
